mustafa11313/intelligent-cnc-vertical-drilling-machine/cad/electrical_box.png

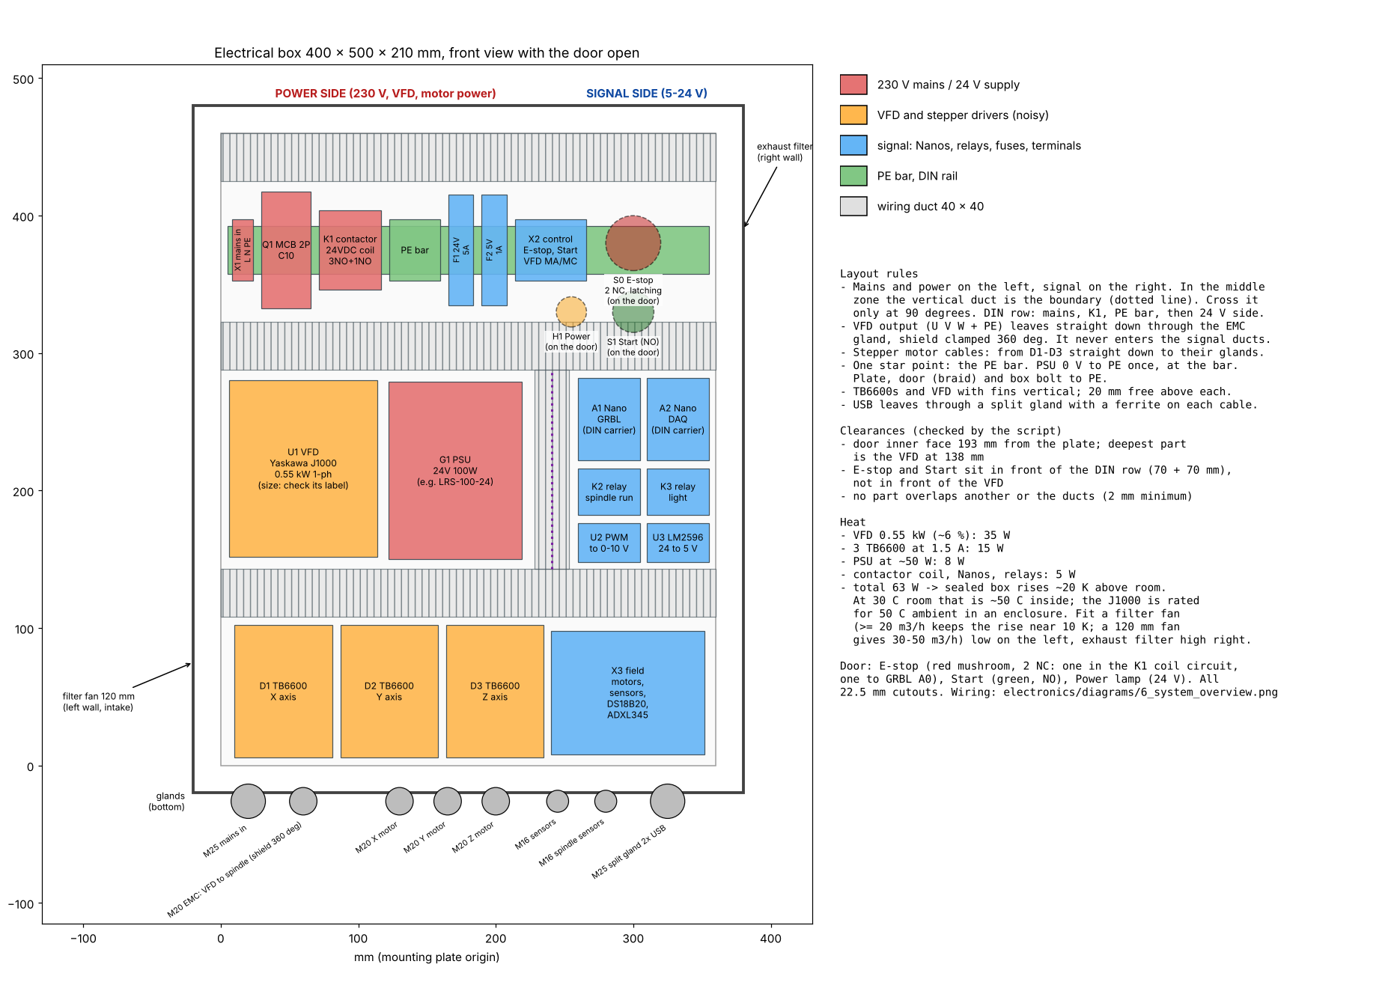
cad/electrical_box.png
