mustafa11313/intelligent-cnc-vertical-drilling-machine/cad/pictures/electrical_box_inside_closeup.png

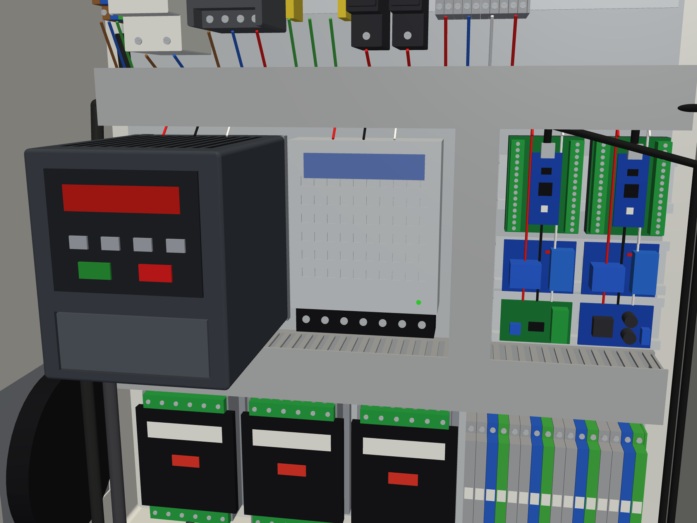
cad/pictures/electrical_box_inside_closeup.png
