mustafa11313/intelligent-cnc-vertical-drilling-machine/cad/pictures/electrical_box_iso_left.png

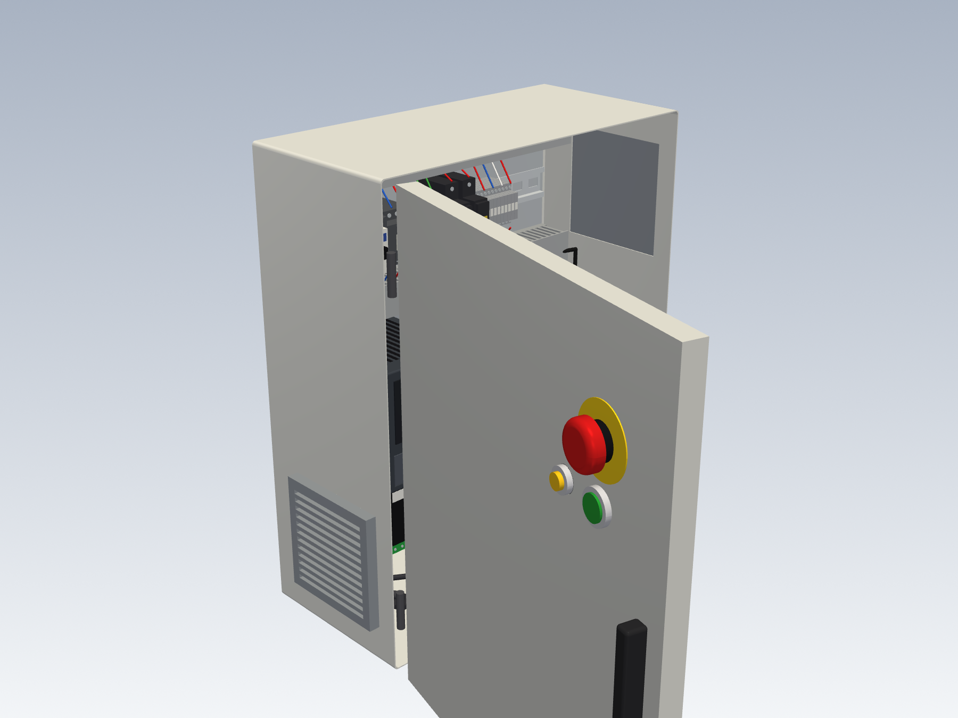
cad/pictures/electrical_box_iso_left.png
