mustafa11313/intelligent-cnc-vertical-drilling-machine/cad/pictures/machine_original_back.png

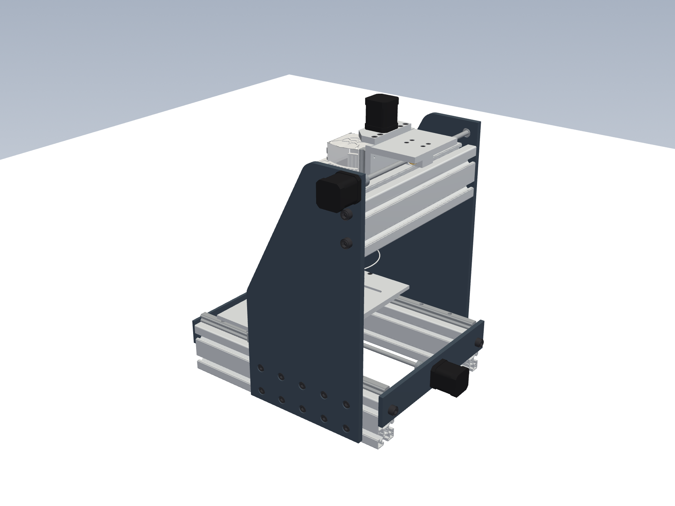
cad/pictures/machine_original_back.png
