mustafa11313/intelligent-cnc-vertical-drilling-machine/cad/pictures/machine_original_front.png

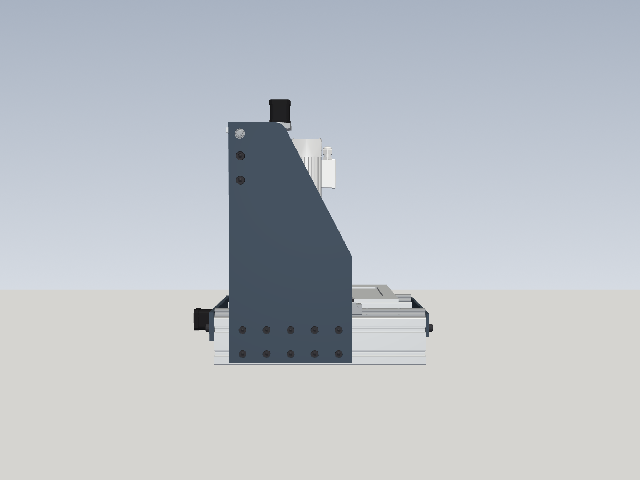
cad/pictures/machine_original_front.png
