mustafa11313/intelligent-cnc-vertical-drilling-machine/cad/pictures/machine_original_iso_front_left.png

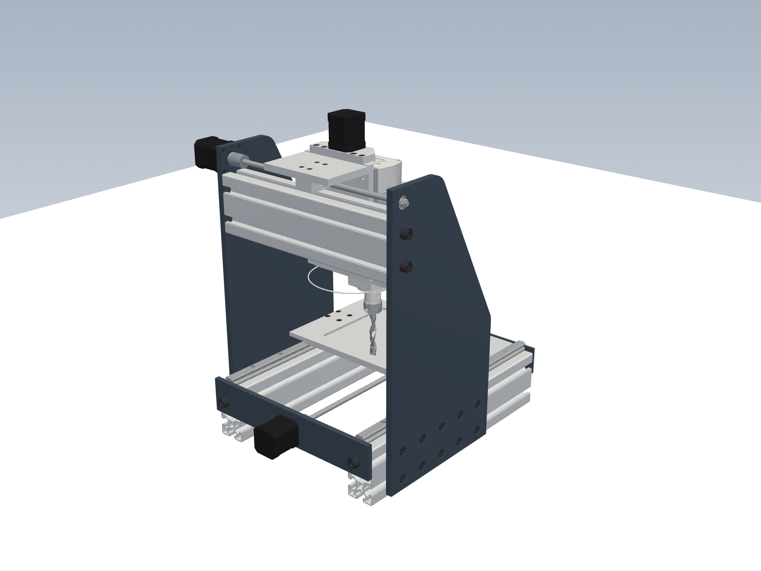
cad/pictures/machine_original_iso_front_left.png
