mustafa11313/intelligent-cnc-vertical-drilling-machine/cad/pictures/machine_original_side.png

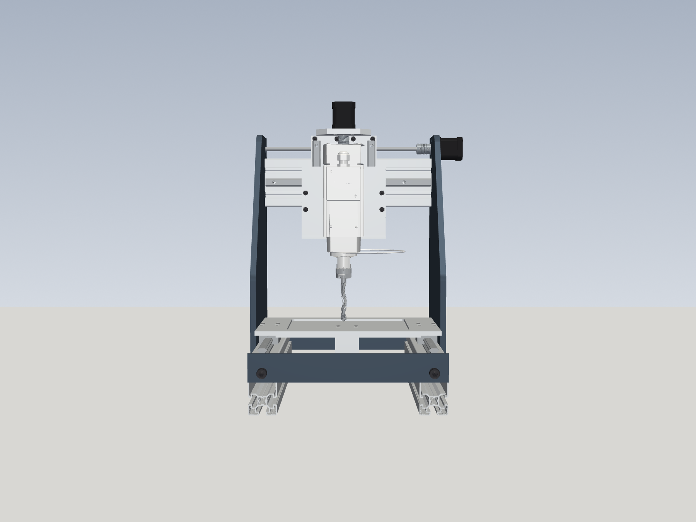
cad/pictures/machine_original_side.png
