mustafa11313/intelligent-cnc-vertical-drilling-machine/cad/pictures/machine_upgraded_head_closeup.png

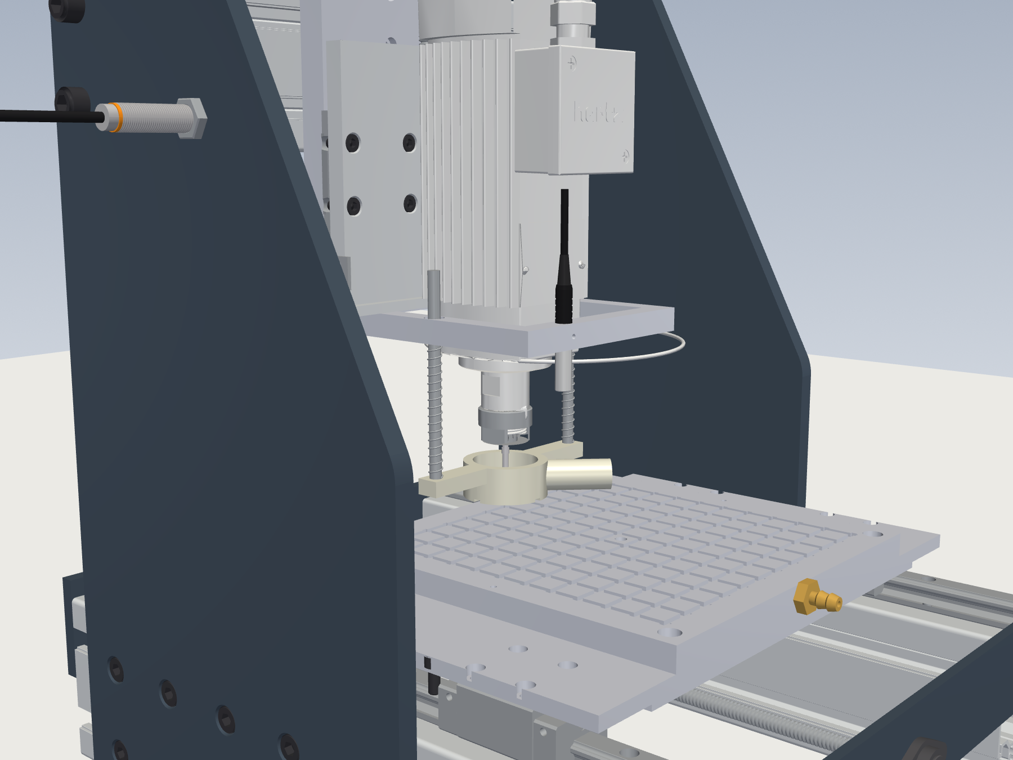
cad/pictures/machine_upgraded_head_closeup.png
