mustafa11313/intelligent-cnc-vertical-drilling-machine/cad/router/pictures/01_front_left.png

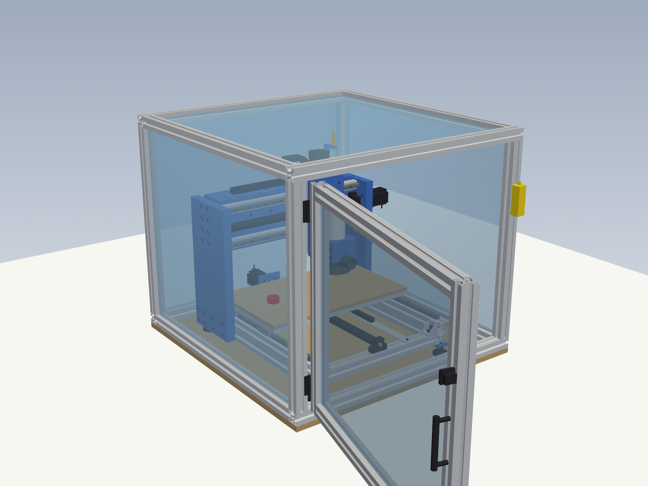
cad/router/pictures/01_front_left.png
