mustafa11313/intelligent-cnc-vertical-drilling-machine/cad/router/pictures/02_front_right.png

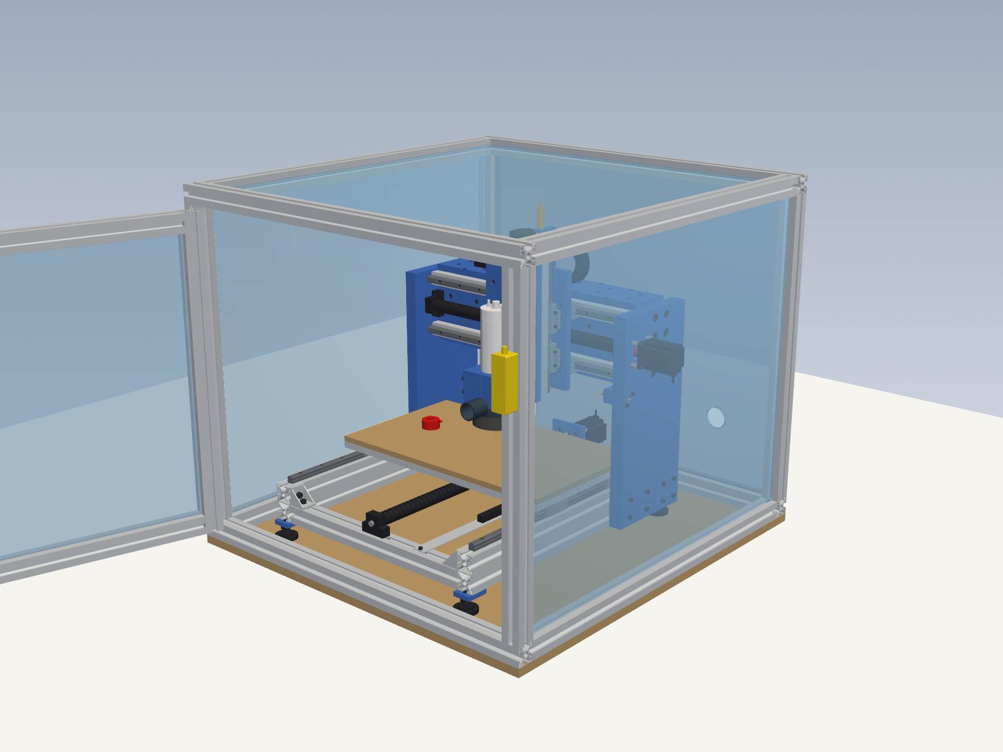
cad/router/pictures/02_front_right.png
