mustafa11313/intelligent-cnc-vertical-drilling-machine/cad/router/pictures/03_front.png

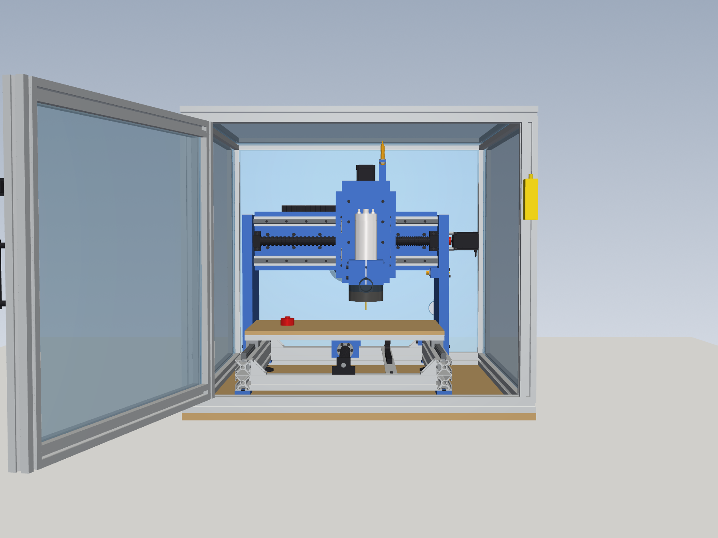
cad/router/pictures/03_front.png
