mustafa11313/intelligent-cnc-vertical-drilling-machine/cad/router/pictures/04_inside_closeup.png

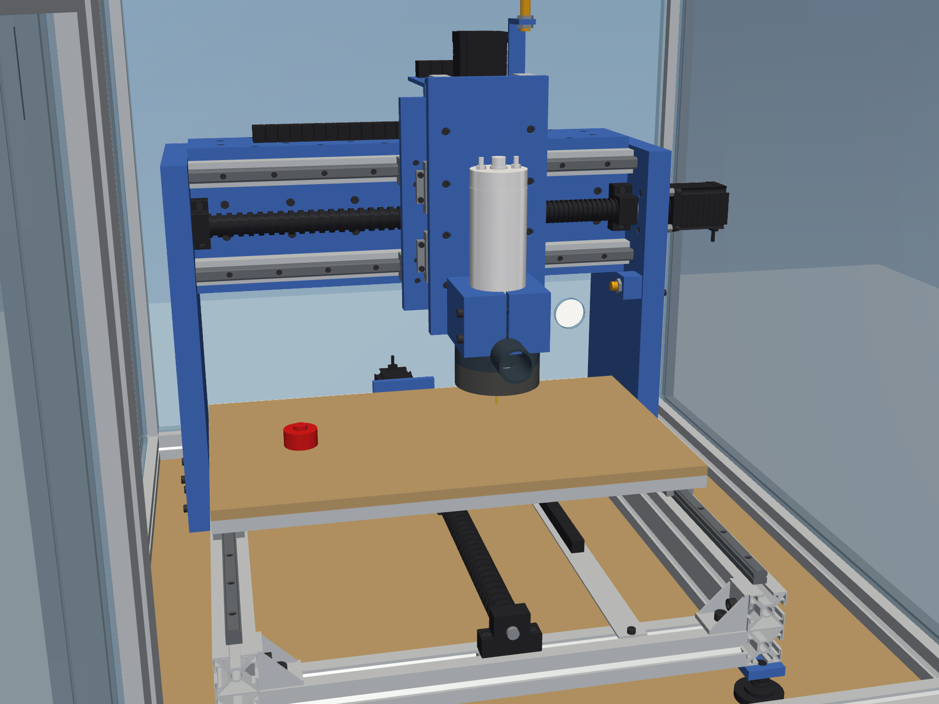
cad/router/pictures/04_inside_closeup.png
