mustafa11313/intelligent-cnc-vertical-drilling-machine/cad/router/pictures/05_top.png

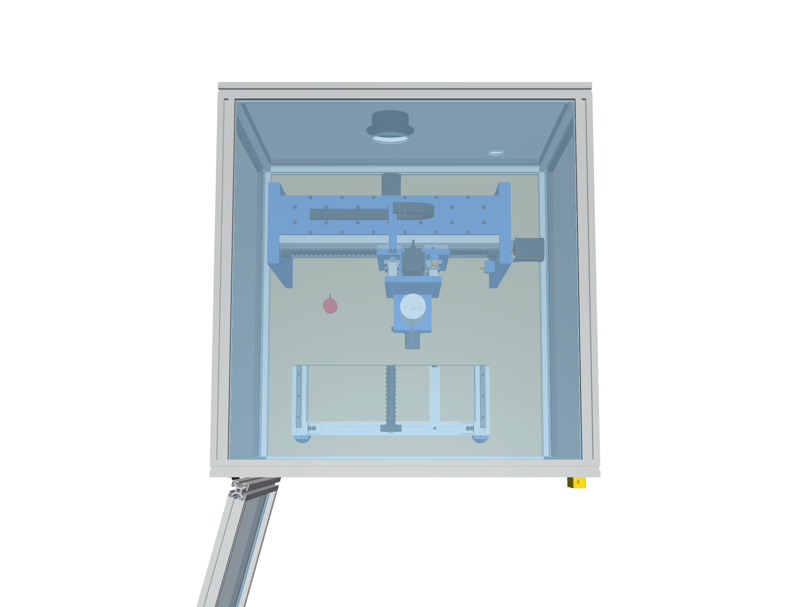
cad/router/pictures/05_top.png
