mustafa11313/intelligent-cnc-vertical-drilling-machine/cad/router/pictures/06_back_right.png

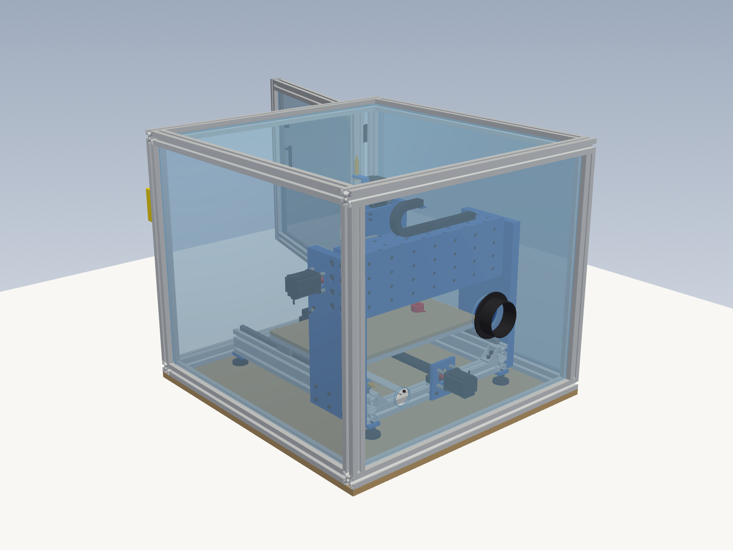
cad/router/pictures/06_back_right.png
