mustafa11313/intelligent-cnc-vertical-drilling-machine/cad/router/pictures/07_left_side.png

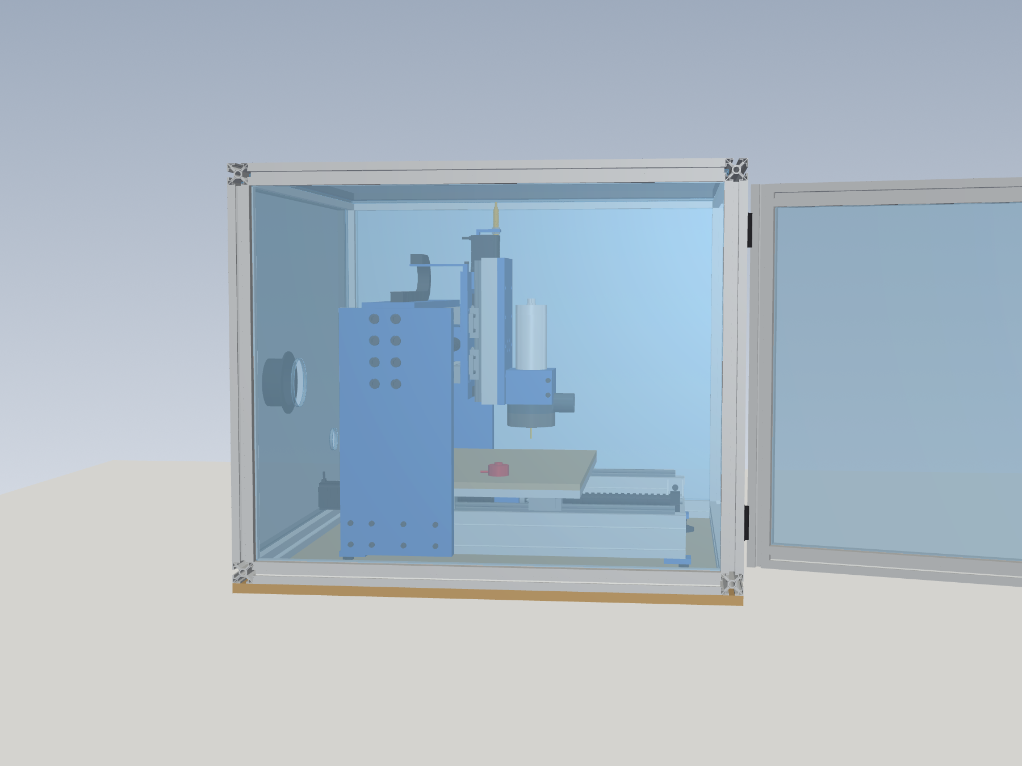
cad/router/pictures/07_left_side.png
