mustafa11313/intelligent-cnc-vertical-drilling-machine/cad/upgrade_views.png

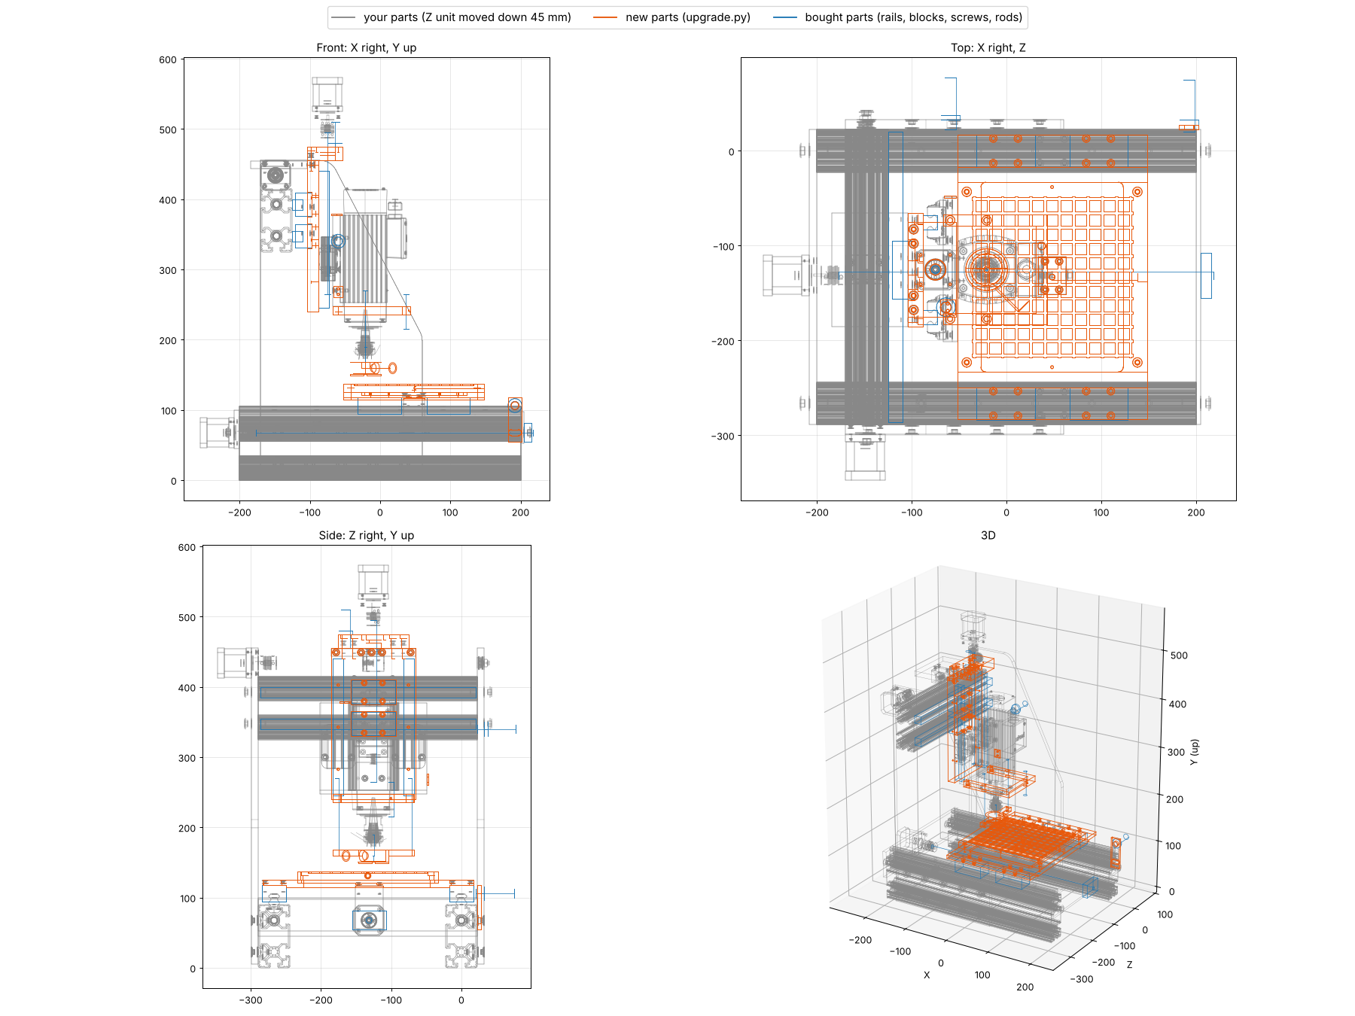
cad/upgrade_views.png
