mustafa11313/intelligent-cnc-vertical-drilling-machine/electronics/diagrams/1_mains_estop.png

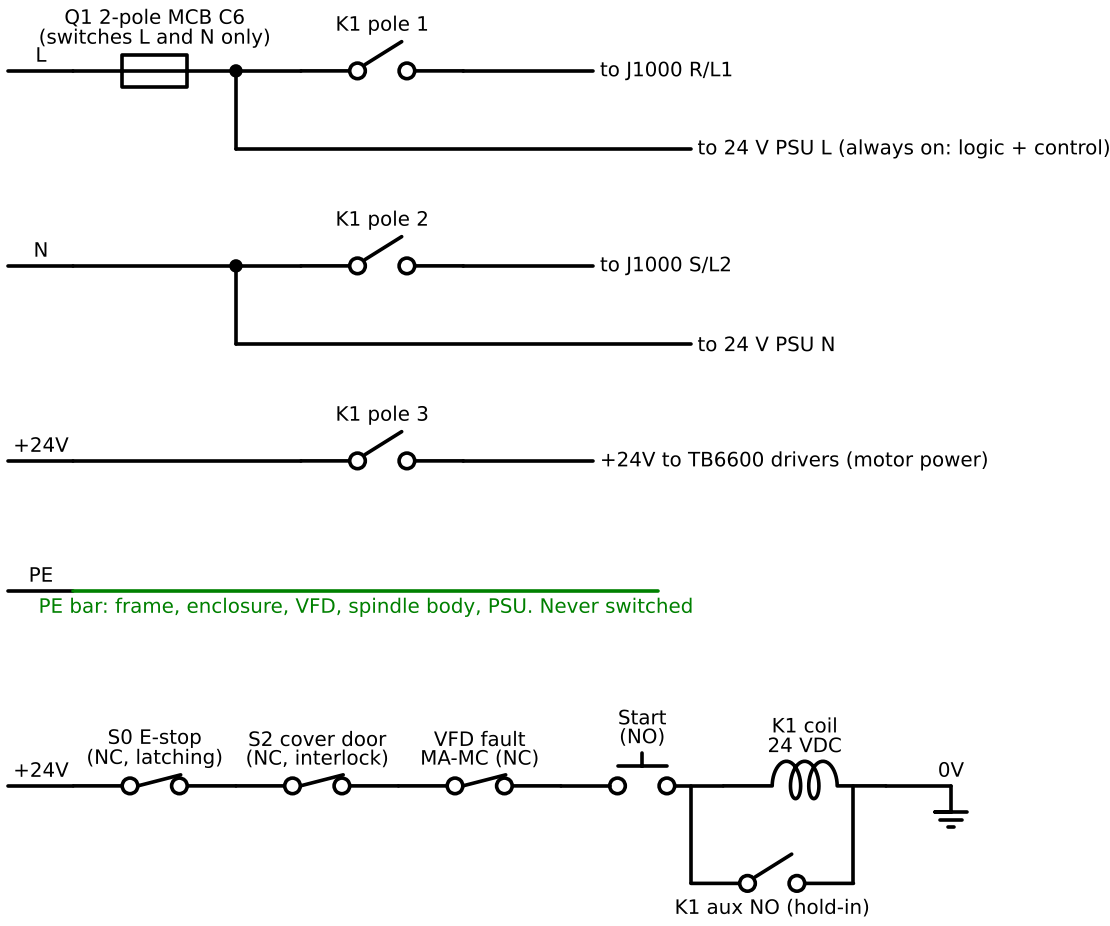
electronics/diagrams/1_mains_estop.png
