mustafa11313/intelligent-cnc-vertical-drilling-machine/electronics/diagrams/2_current_sensor.png

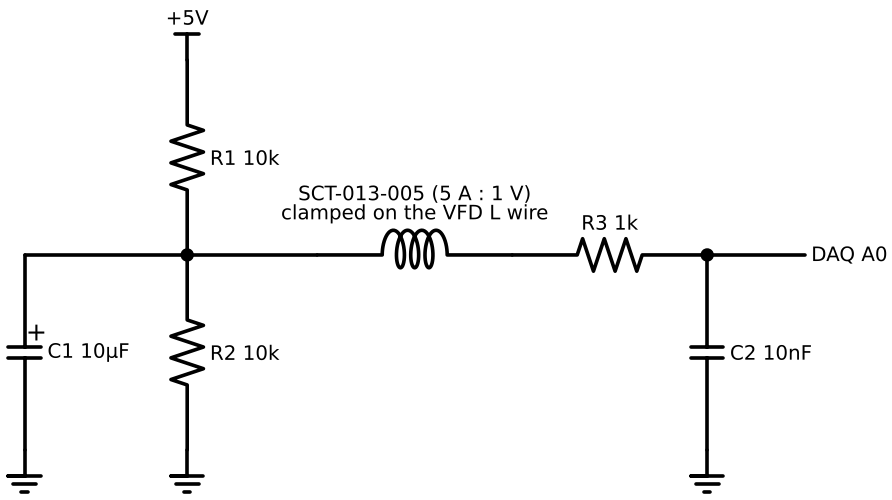
electronics/diagrams/2_current_sensor.png
