mustafa11313/intelligent-cnc-vertical-drilling-machine/electronics/diagrams/3_vfd_analog_monitor.png

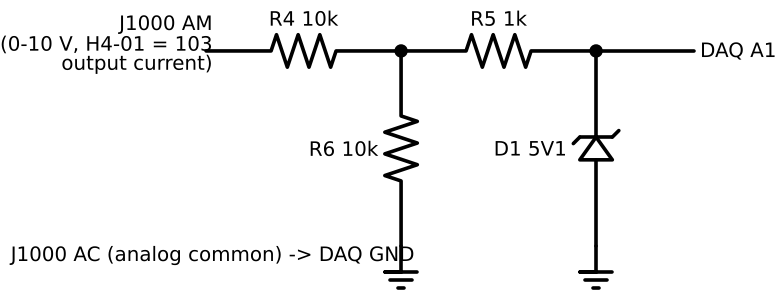
electronics/diagrams/3_vfd_analog_monitor.png
