mustafa11313/intelligent-cnc-vertical-drilling-machine/electronics/diagrams/4_limit_switch.png

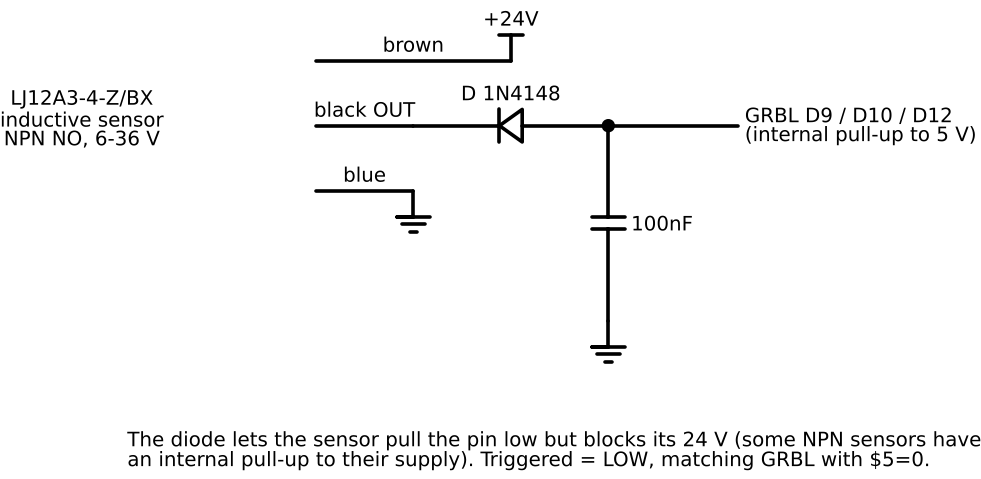
electronics/diagrams/4_limit_switch.png
