mustafa11313/intelligent-cnc-vertical-drilling-machine/electronics/diagrams/5_spindle_control.png

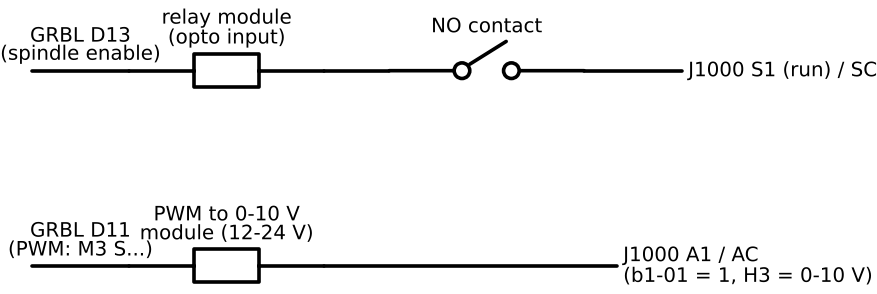
electronics/diagrams/5_spindle_control.png
