mustafa11313/intelligent-cnc-vertical-drilling-machine/electronics/diagrams/6_system_overview.png

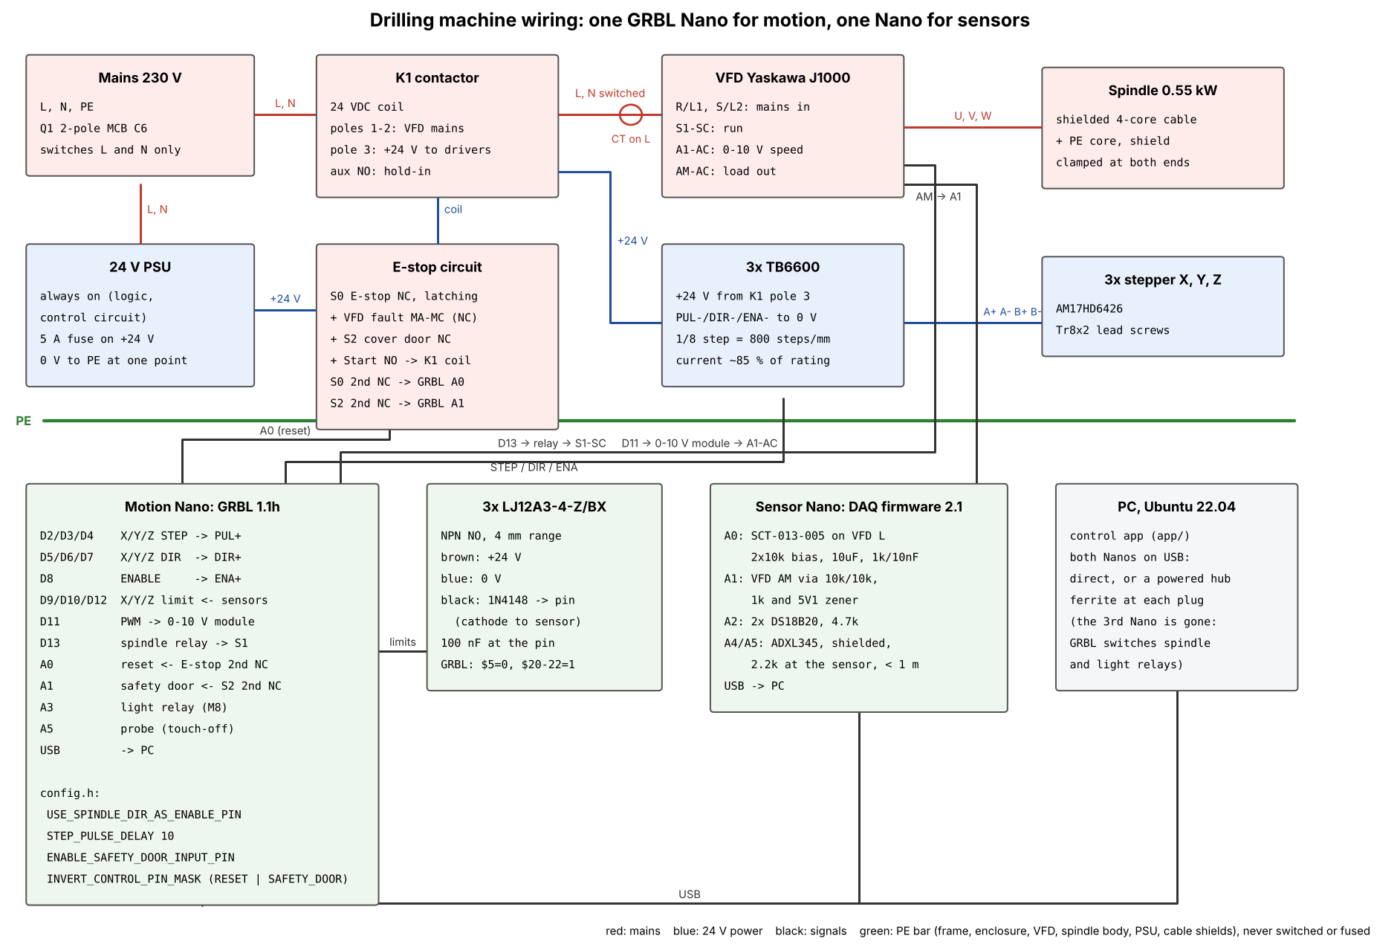
electronics/diagrams/6_system_overview.png
