mustafa11313/intelligent-cnc-vertical-drilling-machine/cad/parts_preview.png

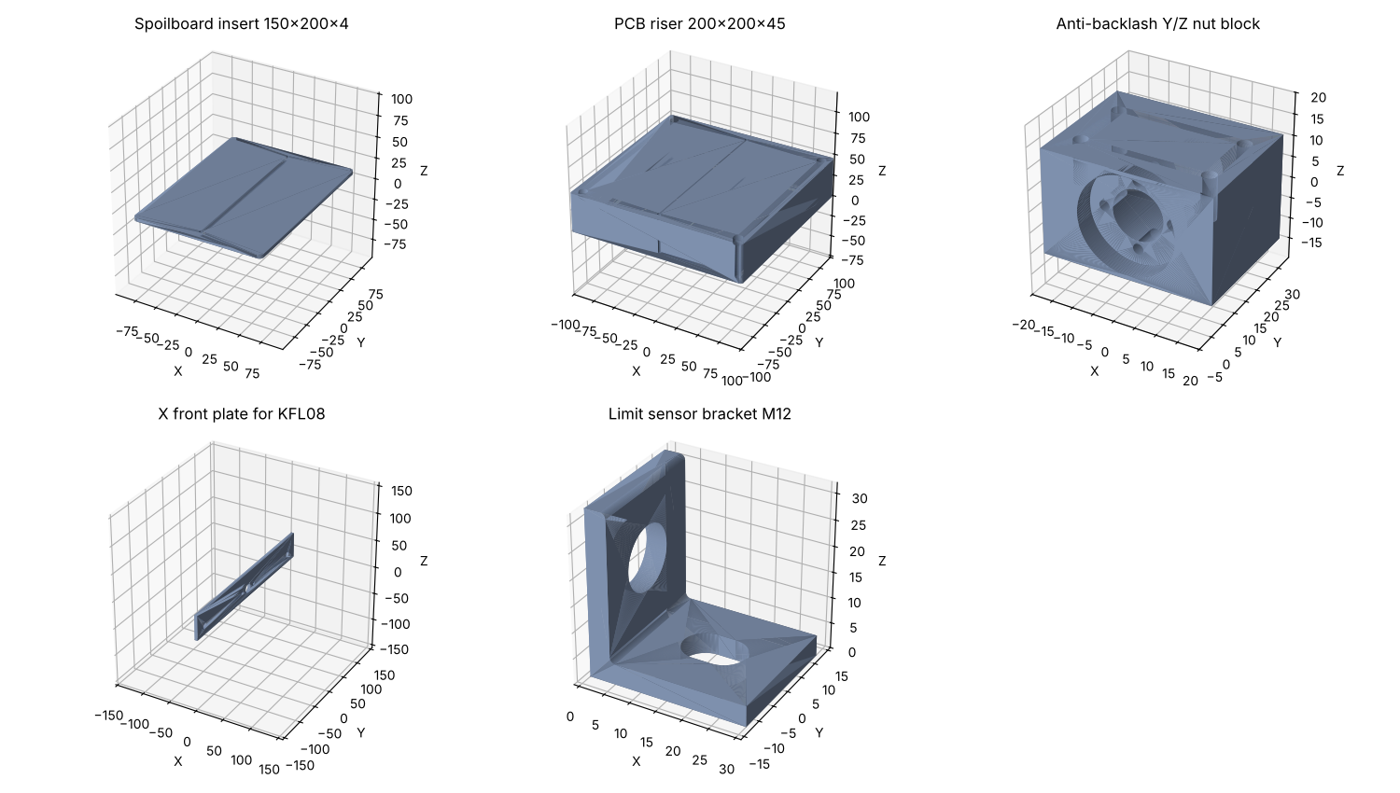
cad/parts_preview.png
