mustafa11313/intelligent-cnc-vertical-drilling-machine/cad/upgrade_parts_preview.png

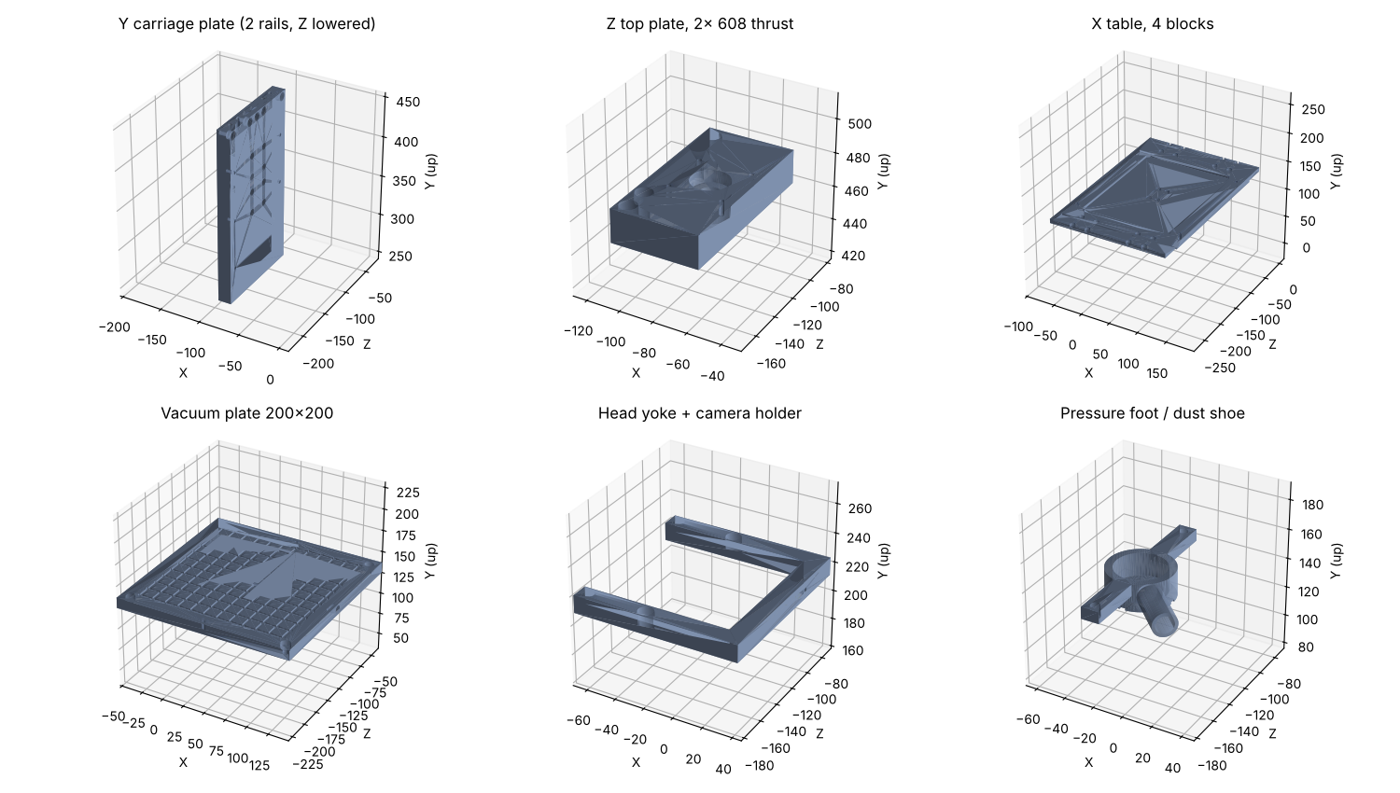
cad/upgrade_parts_preview.png
