mustafa11313/intelligent-cnc-vertical-drilling-machine/cad/step/upgrade_assembly.step

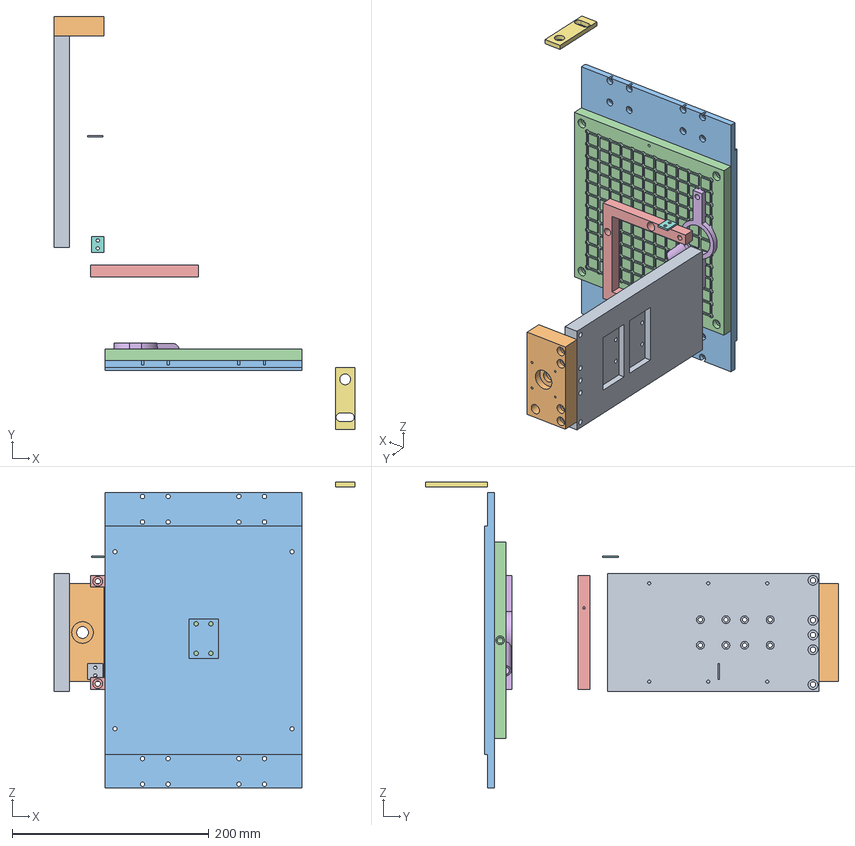
[picture p38: CAD file, 2026-11-08]
cad/step/upgrade_assembly.step
306.0 x 420.0 x 310.7 mm
y_carriage_plate
z_top_plate_608x2
x_table_4block
vacuum_plate_200x200
head_yoke_camera
pressure_foot_dustshoe
x_limit_bracket
y_home_flag
z_home_flag
