mustafa11313/intelligent-cnc-vertical-drilling-machine/cad/step/full_machine_original.step

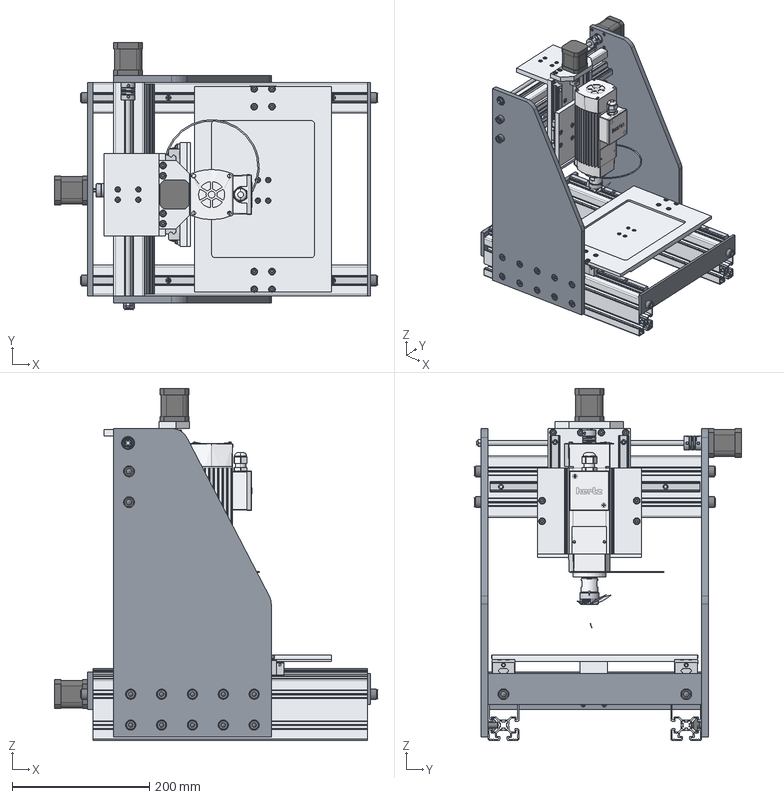
[picture p39: CAD file, 2026-11-08]
cad/step/full_machine_original.step
471.3 x 389.8 x 513.3 mm
ISO 4762 M10 x 20 - 20N
ISO 4762 M10 x 20 - 20N_2
ISO 4762 M10 x 20 - 20N_3
ISO 4762 M10 x 20 - 20N_4
On_Kapak-Son
nut_din934_m6-6
M6_DIN125 PUL
M4x12(ISO 4762 M4 x 12 - 12N)
M4x12(ISO 4762 M4 x 12 - 12N)_2
M4x12(ISO 4762 M4 x 12 - 12N)_3
M4x12(ISO 4762 M4 x 12 - 12N)_4
VidalÄ± mil somunu
X Eksen Somunu
M5x12(ISO 4762 M5 x 12 - 12N)
M5x12(ISO 4762 M5 x 12 - 12N)_2
M5x12(ISO 4762 M5 x 12 - 12N)_3
M5x12(ISO 4762 M5 x 12 - 12N)_4
M5x12(ISO 4762 M5 x 12 - 12N)_5
M5x12(ISO 4762 M5 x 12 - 12N)_6
M5x12(ISO 4762 M5 x 12 - 12N)_7
M5x12(ISO 4762 M5 x 12 - 12N)_8
300x250 Is Tablasi
hgh15ca_01
X_Trapez_Kozmetik_Tr8x2(255)
2.1.001.10.08.step
hgh15ca_01_2
ISO 4762 M8 x 16 - 16N
ISO 4762 M8 x 16 - 16N_2
ISO 4762 M8 x 16 - 16N_3
ISO 4762 M8 x 16 - 16N_4
ISO 4762 M8 x 16 - 16N_5
ISO 4762 M8 x 16 - 16N_6
ISO 4762 M8 x 16 - 16N_7
ISO 4762 M8 x 16 - 16N_8
ISO 4762 M8 x 16 - 16N_9
ISO 4762 M8 x 16 - 16N_10
ISO 4762 M8 x 16 - 16N_11
ISO 4762 M8 x 16 - 16N_12
ISO 4762 M8 x 16 - 16N_13
ISO 4762 M8 x 16 - 16N_14
ISO 4762 M8 x 16 - 16N_15
ISO 4762 M8 x 16 - 16N_16
ISO 4762 M8 x 16 - 16N_17
ISO 4762 M8 x 16 - 16N_18
ISO 4762 M8 x 16 - 16N_19
ISO 4762 M8 x 16 - 16N_20
ISO 4762 M10 x 20 - 20N_5
ISO 4762 M10 x 20 - 20N_6
ISO 4762 M10 x 20 - 20N_7
ISO 4762 M10 x 20 - 20N_8
M4x12(ISO 4762 M4 x 12 - 12N)_5
M4x12(ISO 4762 M4 x 12 - 12N)_6
M4x12(ISO 4762 M4 x 12 - 12N)_7
M4x12(ISO 4762 M4 x 12 - 12N)_8
M5x12(ISO 4762 M5 x 12 - 12N)_9
M5x12(ISO 4762 M5 x 12 - 12N)_10
M5x12(ISO 4762 M5 x 12 - 12N)_11
M5x12(ISO 4762 M5 x 12 - 12N)_12
M5x12(ISO 4762 M5 x 12 - 12N)_13
VidalÄ± mil somunu_2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
