mustafa11313/intelligent-cnc-vertical-drilling-machine/cad/original_solidworks/Step_Motor_AM17HD6426-06N.SLDASM

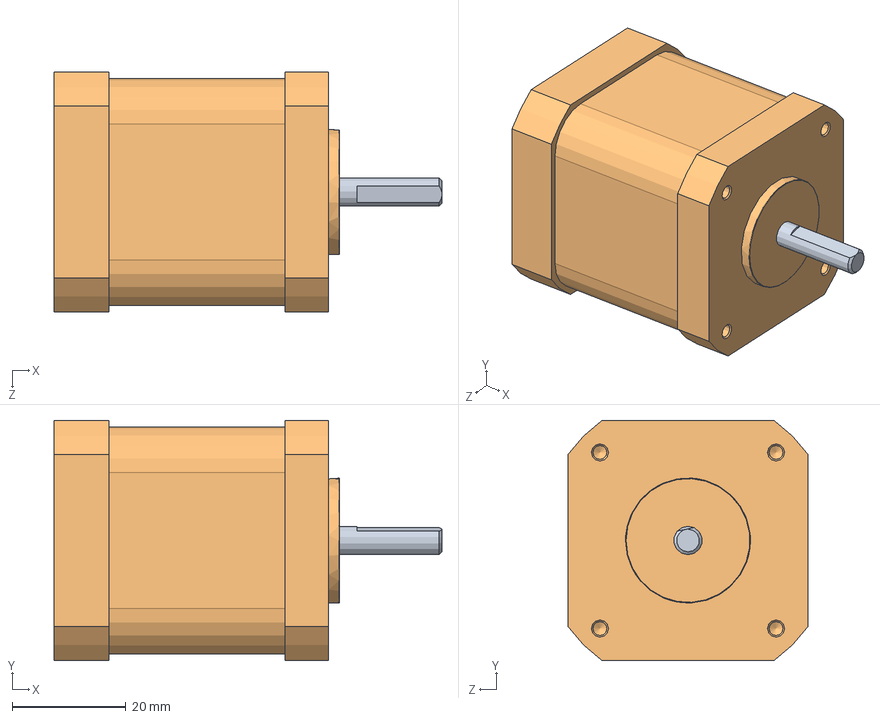
[picture p40: CAD file, 2026-11-08]
cad/original_solidworks/Step_Motor_AM17HD6426-06N.SLDASM
68.3 x 42.3 x 42.3 mm
stepper_am17hd6426-06n_01
stepper_am17hd6426-06n_02
