mustafa11313/intelligent-cnc-vertical-drilling-machine/cad/original_solidworks/ER 161.SLDPRT

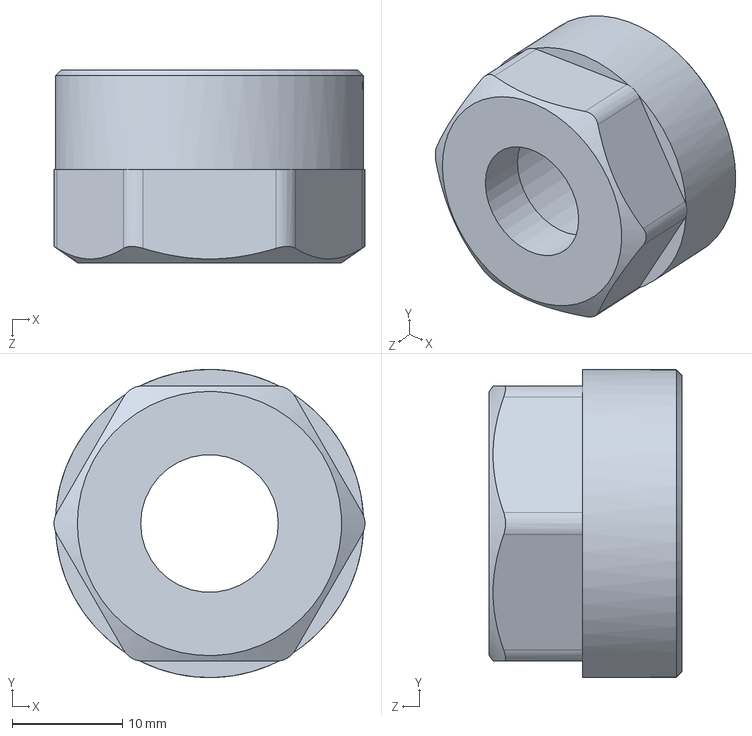
[picture p41: CAD file, 2026-11-08]
cad/original_solidworks/ER 161.SLDPRT
28.2 x 28.0 x 17.5 mm
