mustafa11313/intelligent-cnc-vertical-drilling-machine/cad/step/upgrade/pressure_foot_dustshoe.step

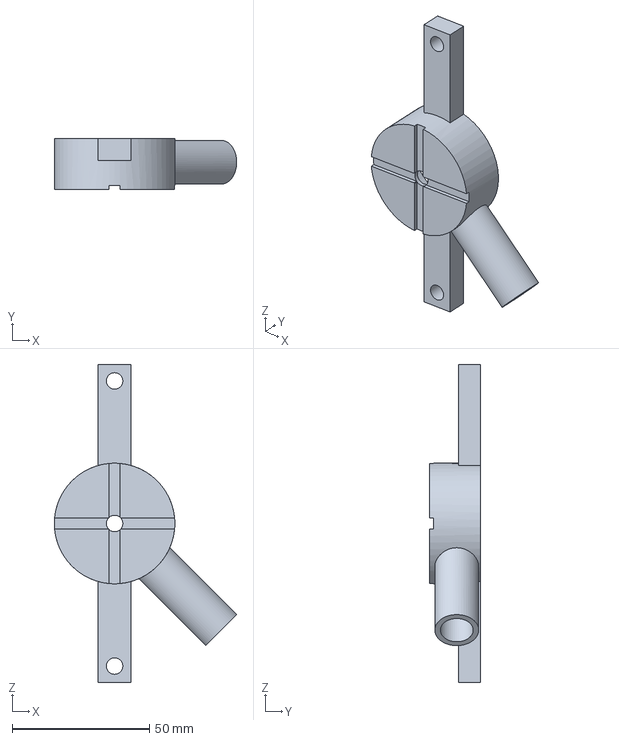
[picture p42: CAD file, 2026-11-08]
cad/step/upgrade/pressure_foot_dustshoe.step
66.5 x 18.7 x 116.0 mm
