mustafa11313/intelligent-cnc-vertical-drilling-machine/cad/original_solidworks/Yan_Plaka_2.SLDPRT

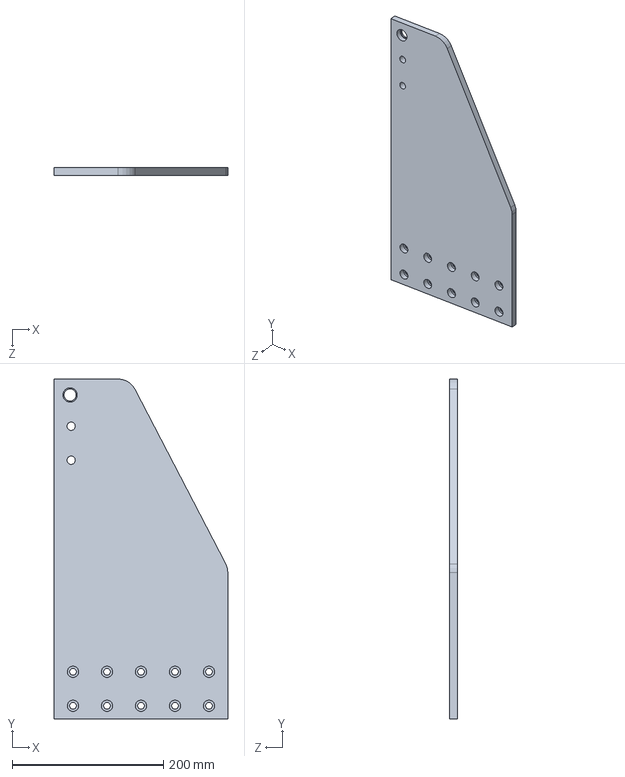
[picture p44: CAD file, 2026-11-08]
cad/original_solidworks/Yan_Plaka_2.SLDPRT
230.0 x 450.0 x 10.0 mm
