mustafa11313/intelligent-cnc-vertical-drilling-machine/cad/step/enclosure.step

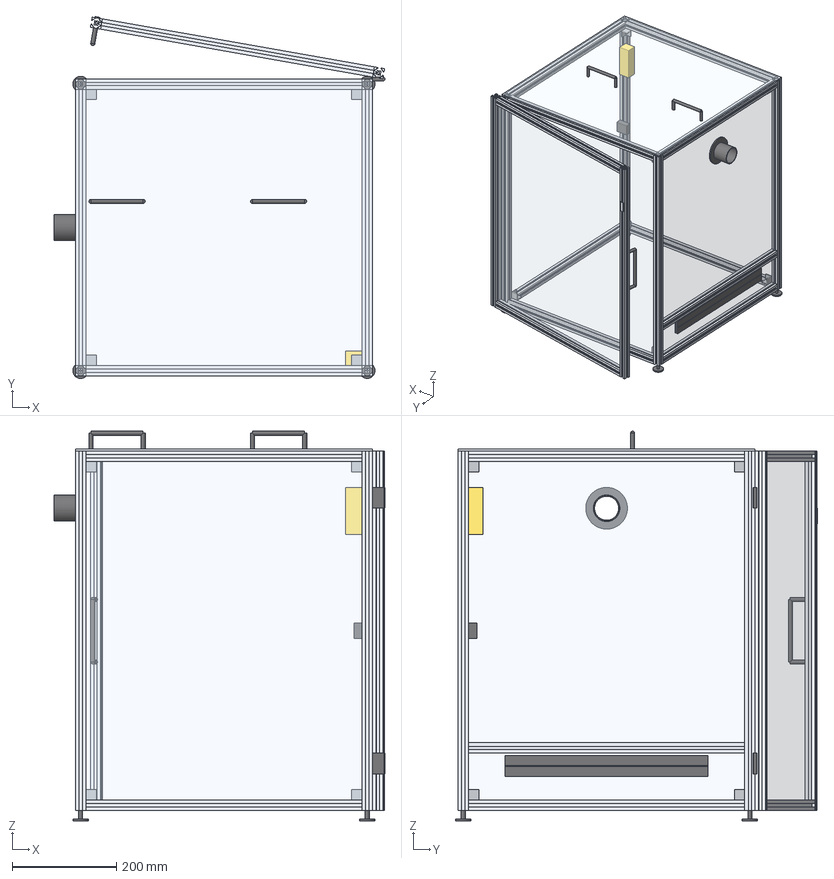
[picture p45: CAD file, 2026-11-08]
cad/step/enclosure.step
635.0 x 694.8 x 748.0 mm
profile 20x20 vertical
profile 20x20 vertical_2
profile 20x20 vertical_3
profile 20x20 vertical_4
profile 20x20 X
profile 20x20 X_2
profile 20x20 Z
profile 20x20 Z_2
profile 20x20 X_3
profile 20x20 X_4
profile 20x20 Z_3
profile 20x20 Z_4
profile 20x20 Z_5
corner bracket 20
corner bracket 20_2
corner bracket 20_3
corner bracket 20_4
corner bracket 20_5
corner bracket 20_6
corner bracket 20_7
corner bracket 20_8
polycarbonate side panel
polycarbonate side panel_2
polycarbonate back panel, low (cable entry)
brush strip cable entry
polycarbonate back panel, high
extraction port 50 mm
polycarbonate lid 6 mm (removable)
lid handle
lid handle_2
door profile vertical
door profile vertical_2
door profile horizontal
door profile horizontal_2
polycarbonate door panel
door handle
interlock actuator key
door hinge
door hinge_2
door interlock switch 2NC (e.g. Omron D4NS)
magnetic catch
levelling foot M8
levelling foot M8_2
levelling foot M8_3
levelling foot M8_4
