mustafa11313/intelligent-cnc-vertical-drilling-machine/cad/step/upgrade/z_top_plate_608x2.step

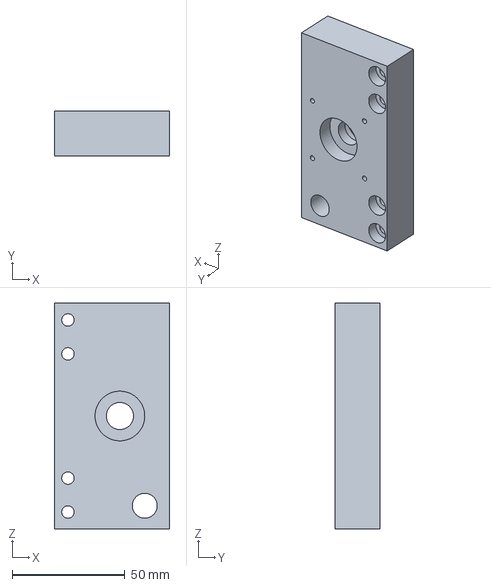
[picture p46: CAD file, 2026-11-08]
cad/step/upgrade/z_top_plate_608x2.step
51.0 x 20.0 x 100.0 mm
