mustafa11313/intelligent-cnc-vertical-drilling-machine/tests/data/Spicemen.DXF

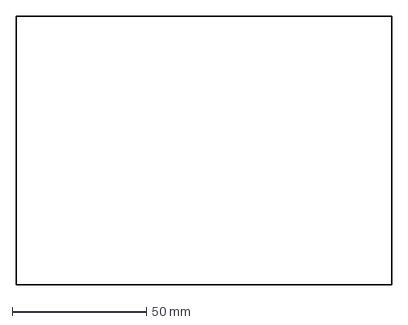
[picture p47: CAD file, 2026-11-08]
tests/data/Spicemen.DXF
140.0 x 100.0 mm
