mustafa11313/intelligent-cnc-vertical-drilling-machine/cad/original_solidworks/M3 x12.SLDPRT

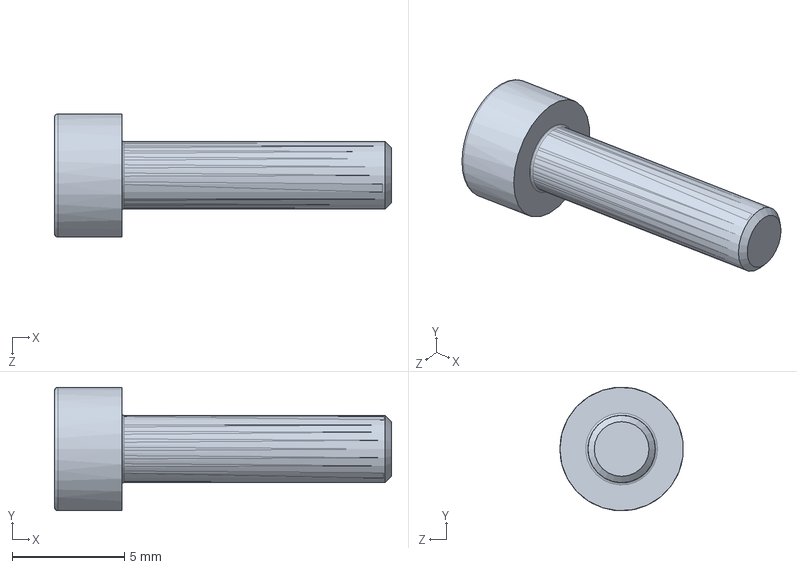
[picture p48: CAD file, 2026-11-08]
cad/original_solidworks/M3 x12.SLDPRT
15.0 x 5.49 x 5.49 mm
