mustafa11313/intelligent-cnc-vertical-drilling-machine/cad/step/electrical_box.step

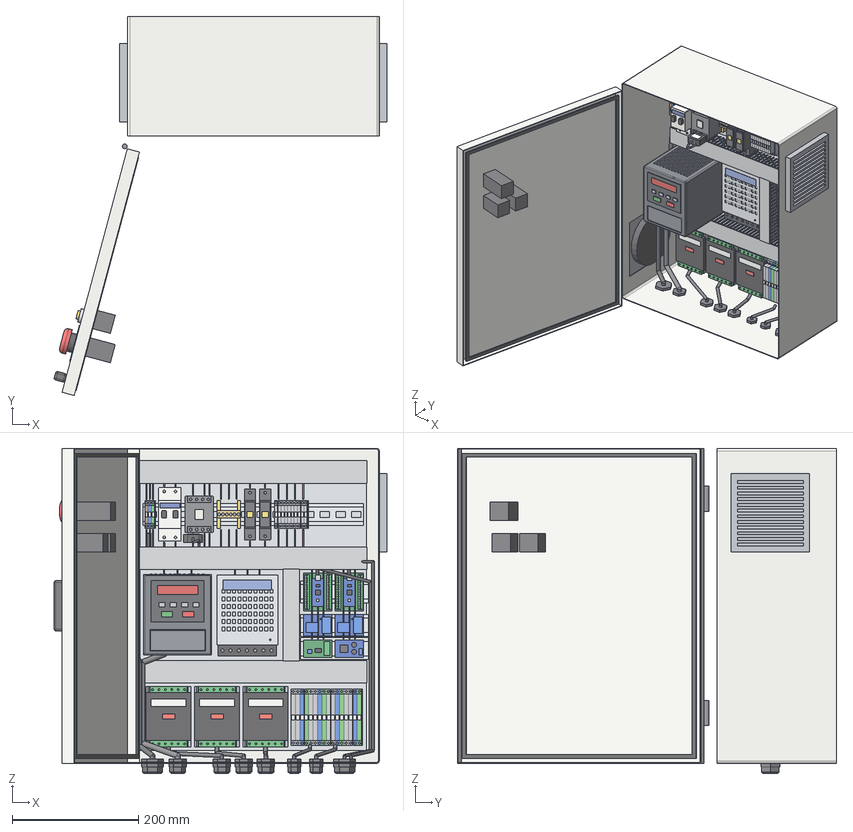
[picture p49: CAD file, 2026-11-08]
cad/step/electrical_box.step
528.1 x 601.5 x 516.5 mm
enclosure 400x500x210 RAL7035
mounting plate galvanised
plate standoff
plate standoff_2
plate standoff_3
plate standoff_4
wiring duct
duct cover
wiring duct_2
duct cover_2
wiring duct_3
duct cover_3
wiring duct_4
duct cover_4
DIN rail TS35
DIN rail TS35_2
DIN rail TS35_3
DIN rail TS35_4
X1_mains terminal
X1_mains screw
X1_mains screw_2
X1_mains marker
X1_mains terminal_2
X1_mains screw_3
X1_mains screw_4
X1_mains marker_2
X1_mains terminal_3
X1_mains screw_5
X1_mains screw_6
X1_mains marker_3
X1_mains end plate
Q1_mcb MCB body
Q1_mcb MCB toggle
Q1_mcb MCB screw
Q1_mcb MCB screw_2
Q1_mcb MCB toggle_2
Q1_mcb MCB screw_3
Q1_mcb MCB screw_4
Q1_mcb MCB label C10
K1_contactor contactor LC1K
K1_contactor contactor window
K1_contactor screw
K1_contactor screw_2
K1_contactor screw_3
K1_contactor screw_4
K1_contactor screw_5
K1_contactor screw_6
K1_contactor screw_7
K1_contactor screw_8
PE_bar PE bar insulator
PE_bar PE bar insulator_2
PE_bar PE bar
PE_bar PE screw
PE_bar PE screw_2
PE_bar PE screw_3
PE_bar PE screw_4
PE_bar PE screw_5
PE_bar PE screw_6
F1_fuse fuse holder
F1_fuse fuse carrier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
