mustafa11313/intelligent-cnc-vertical-drilling-machine/cad/step/upgrade/y_home_flag.step

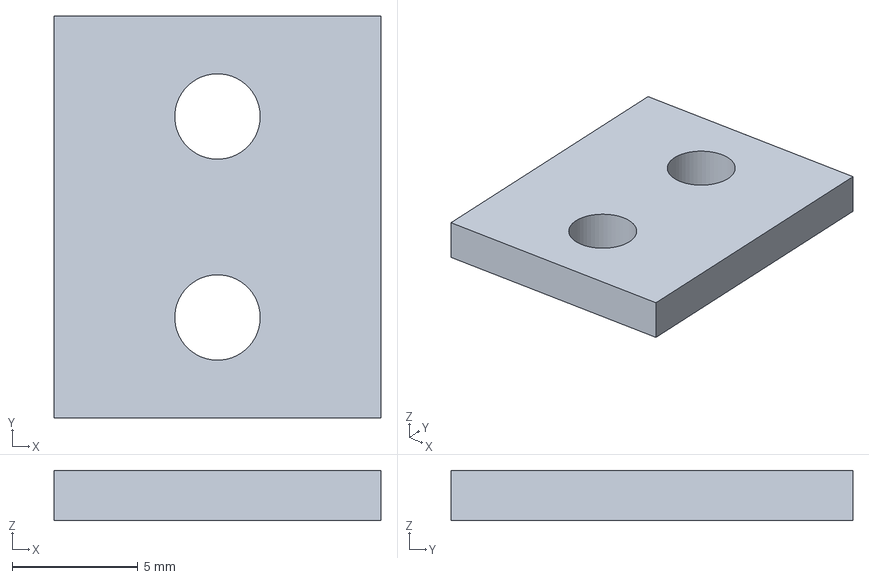
[picture p50: CAD file, 2026-11-08]
cad/step/upgrade/y_home_flag.step
13.0 x 16.0 x 2.00 mm
