mustafa11313/intelligent-cnc-vertical-drilling-machine/cad/original_solidworks/Y eksen takozu.SLDPRT

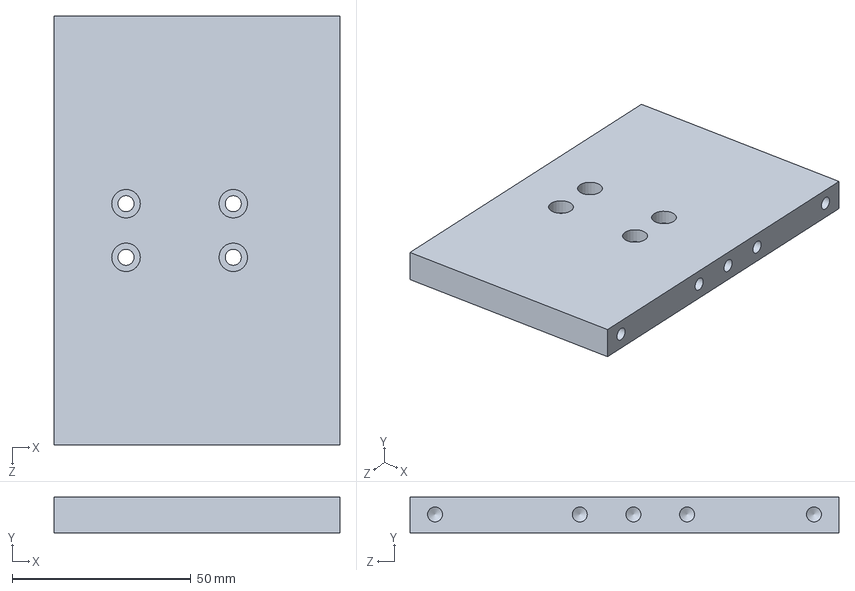
[picture p51: CAD file, 2026-11-08]
cad/original_solidworks/Y eksen takozu.SLDPRT
80.0 x 10.0 x 120.0 mm
