mustafa11313/intelligent-cnc-vertical-drilling-machine/cad/step/upgrade/z_home_flag.step

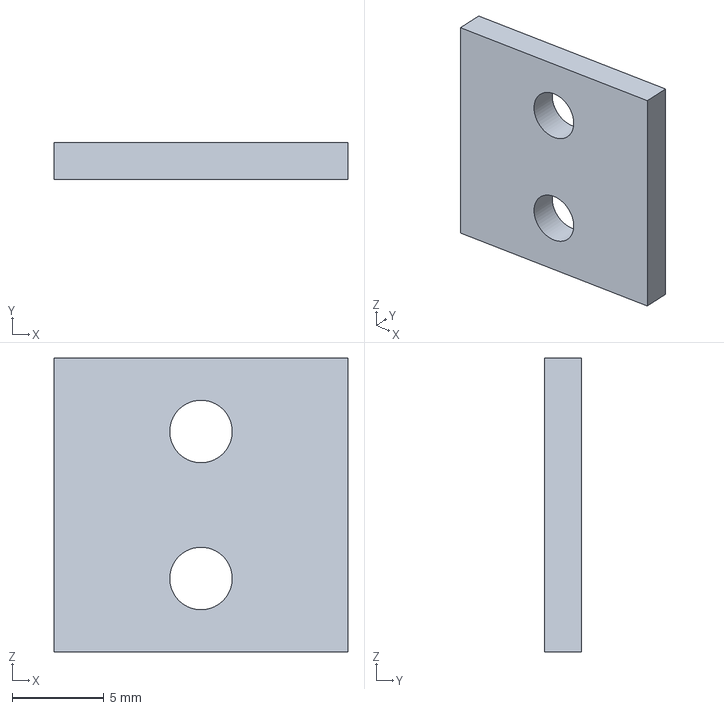
[picture p52: CAD file, 2026-11-08]
cad/step/upgrade/z_home_flag.step
16.0 x 2.00 x 16.0 mm
