mustafa11313/intelligent-cnc-vertical-drilling-machine/tests/data/test.DXF

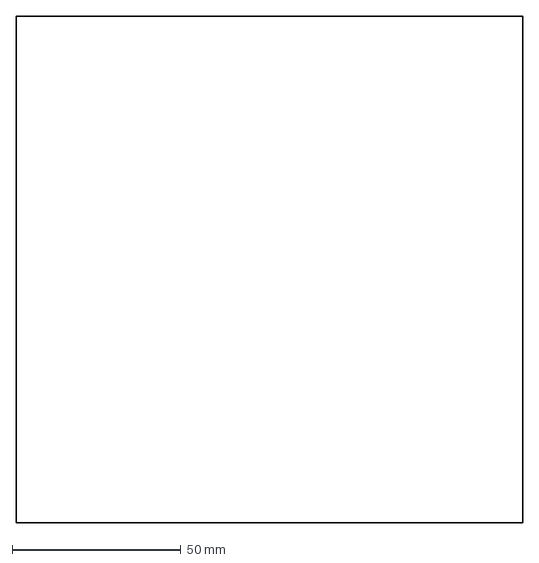
[picture p53: CAD file, 2026-11-08]
tests/data/test.DXF
150.0 x 150.0 mm
