mustafa11313/intelligent-cnc-vertical-drilling-machine/cad/original_solidworks/2.1.001.10.08.step.SLDPRT

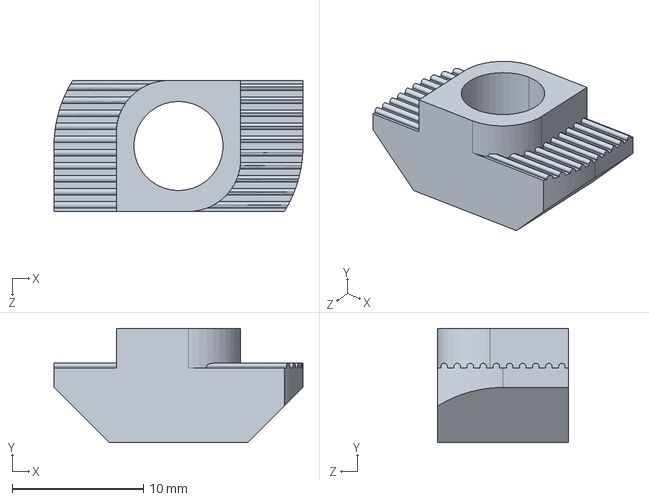
[picture p54: CAD file, 2026-11-08]
cad/original_solidworks/2.1.001.10.08.step.SLDPRT
19.0 x 8.70 x 10.0 mm
