mustafa11313/intelligent-cnc-vertical-drilling-machine/cad/step/upgrade/x_table_4block.step

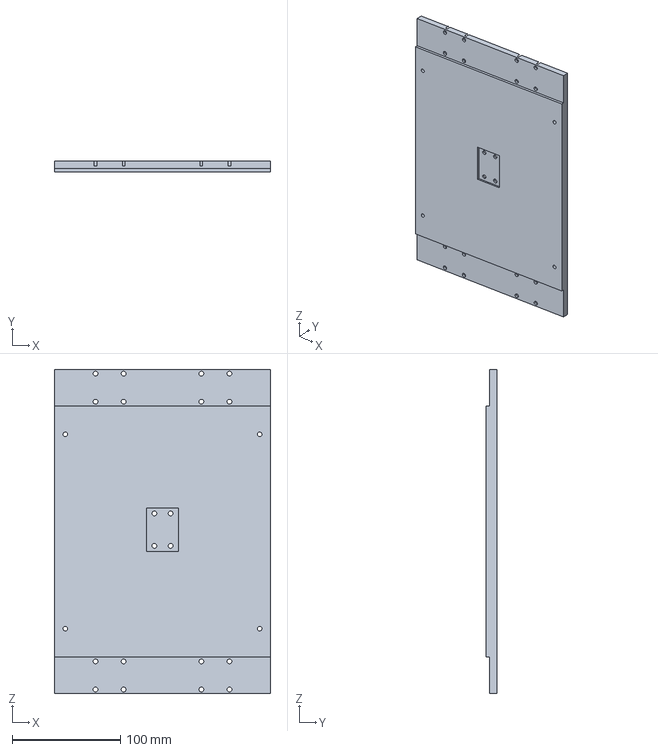
[picture p55: CAD file, 2026-11-08]
cad/step/upgrade/x_table_4block.step
200.0 x 10.0 x 300.0 mm
