mustafa11313/intelligent-cnc-vertical-drilling-machine/tests/data/Spicemen2.DXF

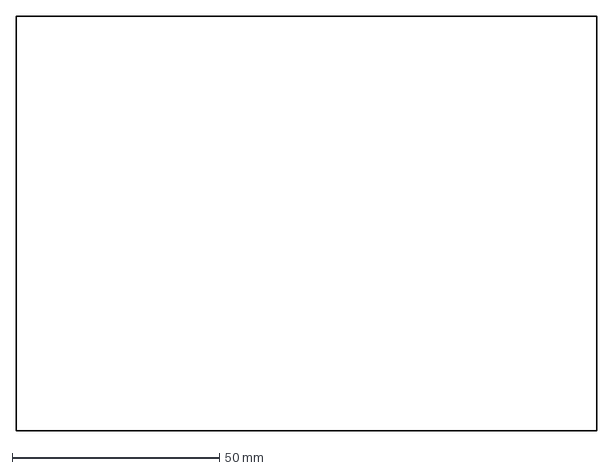
[picture p56: CAD file, 2026-11-08]
tests/data/Spicemen2.DXF
140.0 x 100.0 mm
