mustafa11313/intelligent-cnc-vertical-drilling-machine/cad/step/upgrade/head_yoke_camera.step

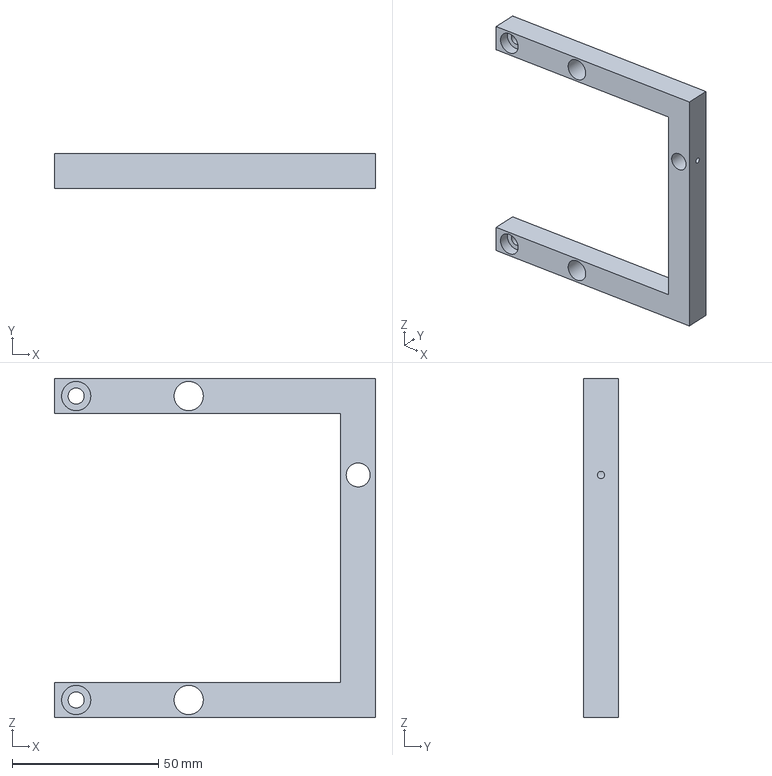
[picture p57: CAD file, 2026-11-08]
cad/step/upgrade/head_yoke_camera.step
110.0 x 12.0 x 116.0 mm
