mustafa11313/intelligent-cnc-vertical-drilling-machine/tests/data/test2.DXF

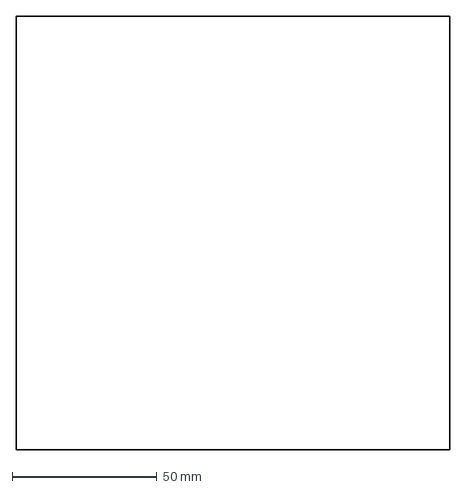
[picture p58: CAD file, 2026-11-08]
tests/data/test2.DXF
150.0 x 150.0 mm
