mustafa11313/intelligent-cnc-vertical-drilling-machine/cad/original_solidworks/Arka Kapak.SLDPRT

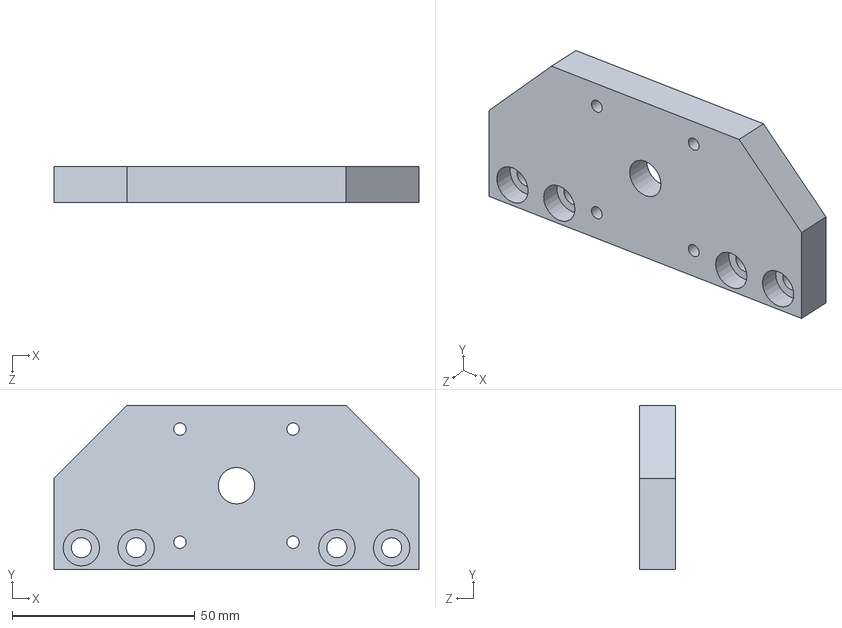
[picture p59: CAD file, 2026-11-08]
cad/original_solidworks/Arka Kapak.SLDPRT
100.0 x 45.0 x 10.0 mm
