mustafa11313/intelligent-cnc-vertical-drilling-machine/cad/step/upgrade/vacuum_plate_200x200.step

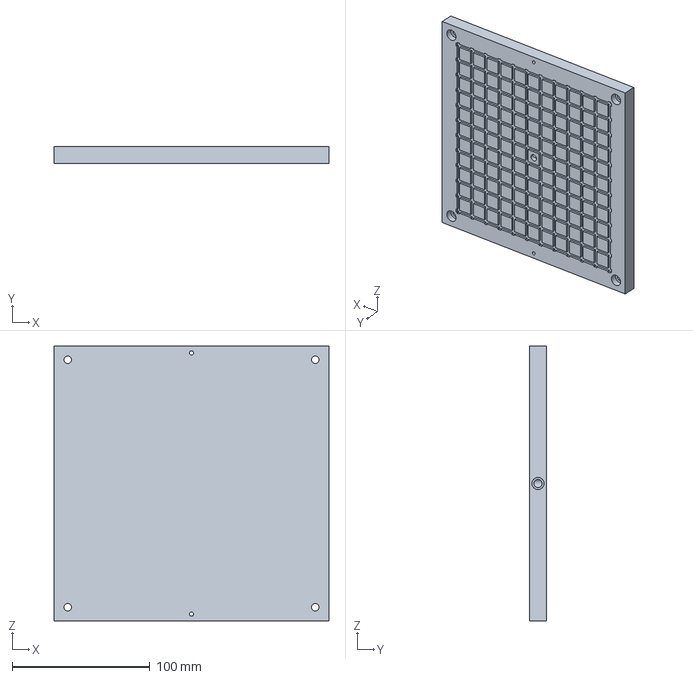
[picture p60: CAD file, 2026-11-08]
cad/step/upgrade/vacuum_plate_200x200.step
200.0 x 12.0 x 200.0 mm
