mustafa11313/intelligent-cnc-vertical-drilling-machine/cad/original_solidworks/626.SLDPRT

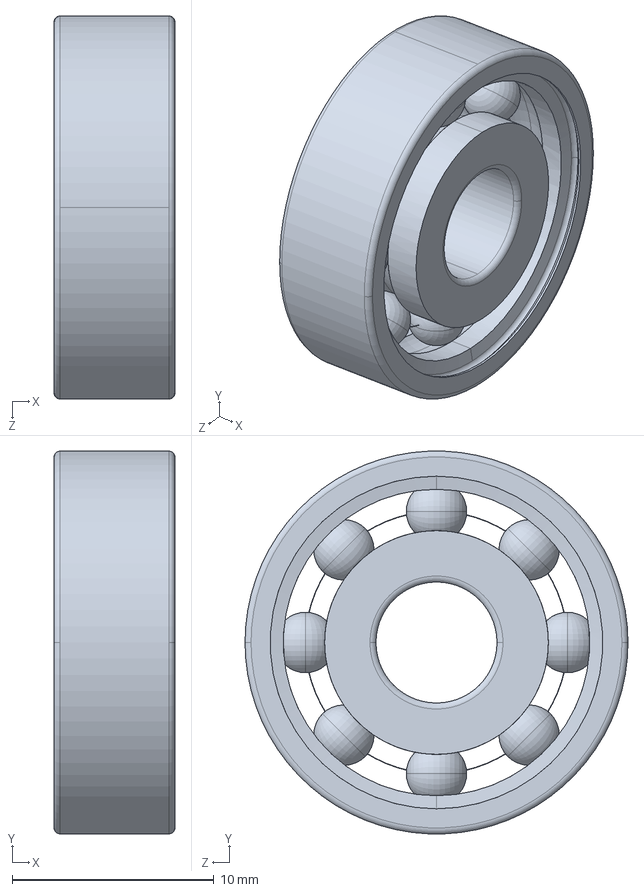
[picture p61: CAD file, 2026-11-08]
cad/original_solidworks/626.SLDPRT
6.00 x 19.0 x 19.0 mm
