mustafa11313/intelligent-cnc-vertical-drilling-machine/cad/step/spoilboard_insert_150x200.step

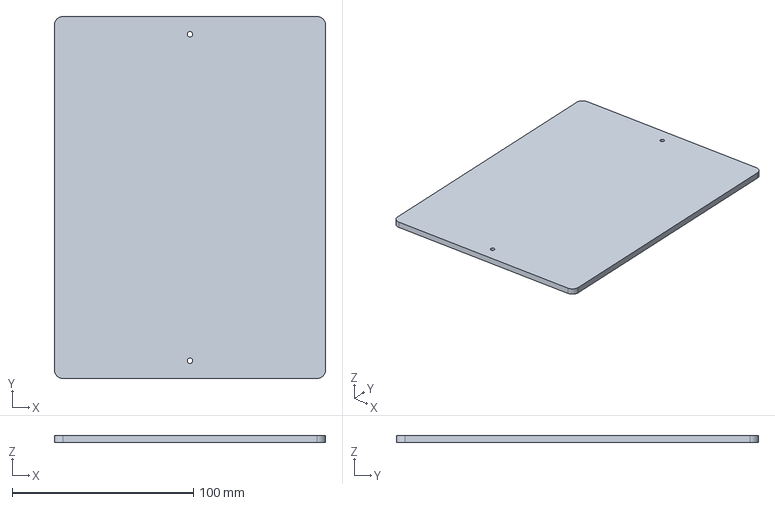
[picture p62: CAD file, 2026-11-08]
cad/step/spoilboard_insert_150x200.step
149.6 x 199.6 x 4.00 mm
