mustafa11313/intelligent-cnc-vertical-drilling-machine/cad/step/upgrade/y_carriage_plate.step

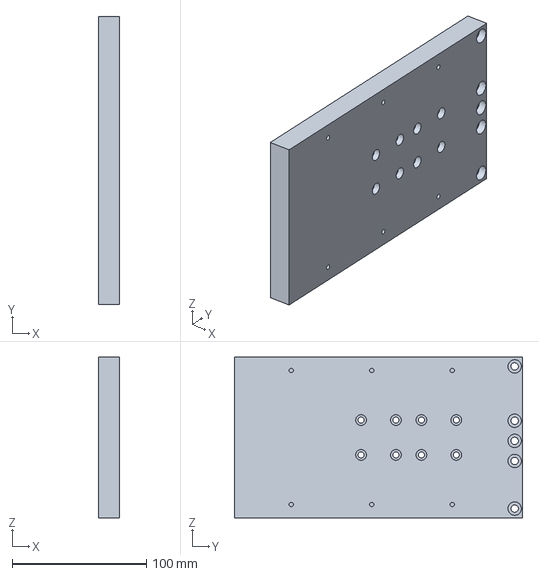
[picture p63: CAD file, 2026-11-08]
cad/step/upgrade/y_carriage_plate.step
16.0 x 215.0 x 120.0 mm
