mustafa11313/intelligent-cnc-vertical-drilling-machine/cad/step/upgrade/x_limit_bracket.step

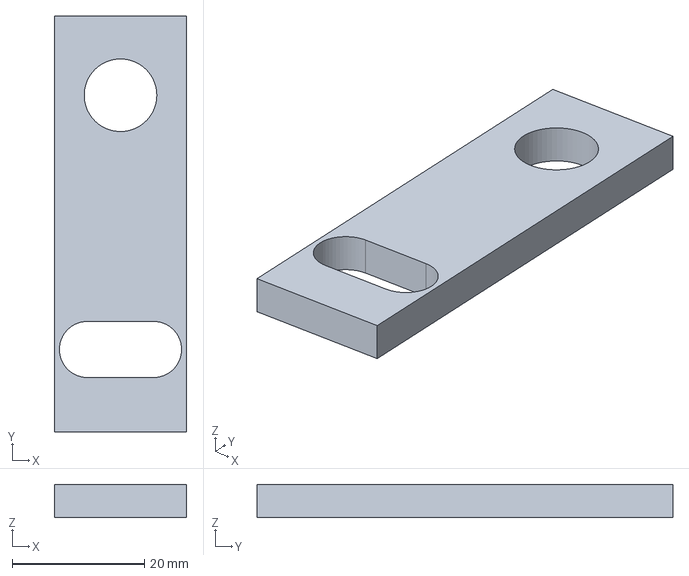
[picture p64: CAD file, 2026-11-08]
cad/step/upgrade/x_limit_bracket.step
20.0 x 63.0 x 5.00 mm
