mustafa11313/intelligent-cnc-vertical-drilling-machine/cad/step/x_front_plate_KFL08.step

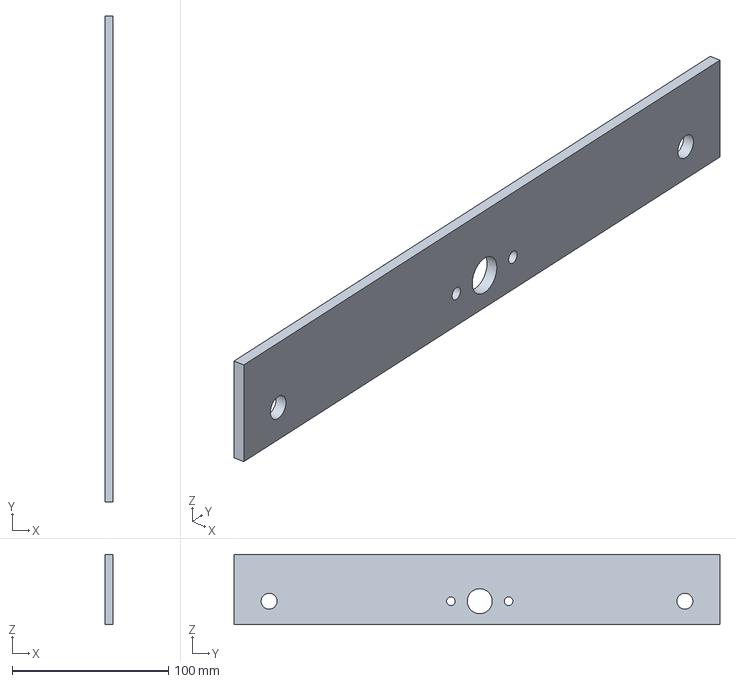
[picture p65: CAD file, 2026-11-08]
cad/step/x_front_plate_KFL08.step
5.00 x 311.5 x 45.0 mm
