mustafa11313/intelligent-cnc-vertical-drilling-machine/cad/original_solidworks/M6_DIN125 PUL.SLDPRT

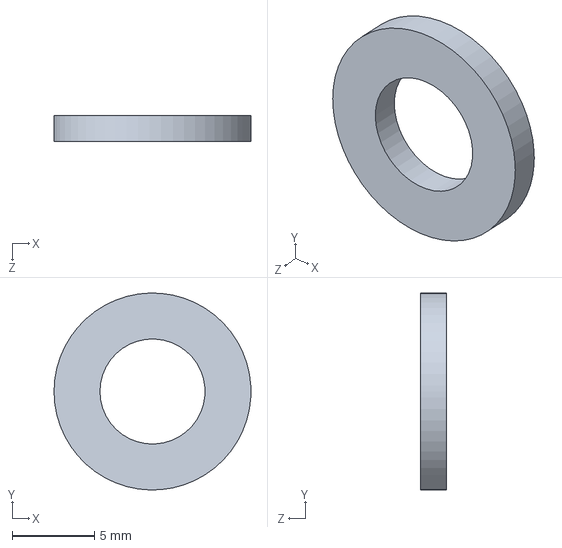
[picture p66: CAD file, 2026-11-08]
cad/original_solidworks/M6_DIN125 PUL.SLDPRT
12.0 x 12.0 x 1.60 mm
