mustafa11313/intelligent-cnc-vertical-drilling-machine/cad/step/limit_sensor_bracket_M12.step

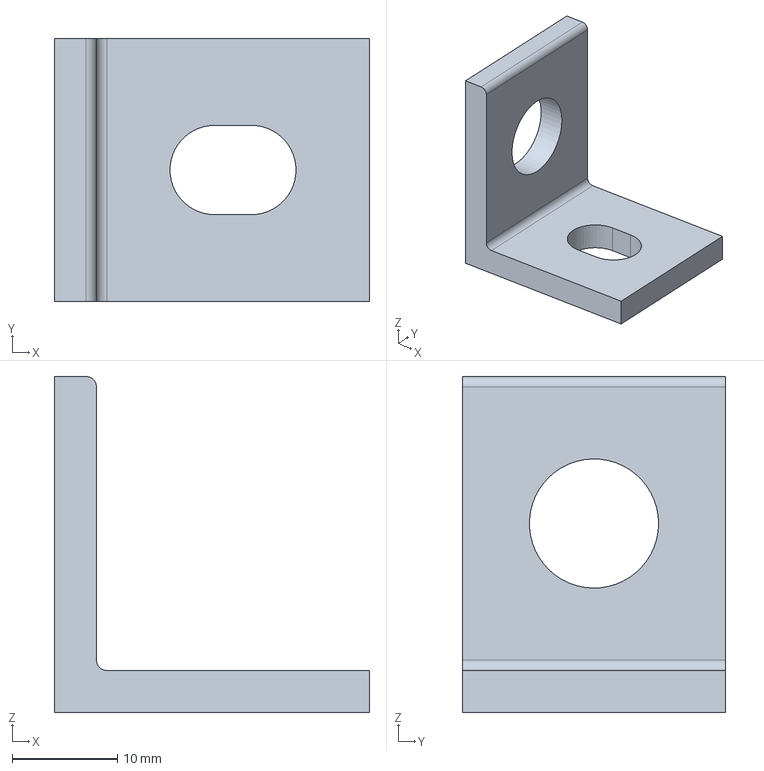
[picture p67: CAD file, 2026-11-08]
cad/step/limit_sensor_bracket_M12.step
30.0 x 25.0 x 32.0 mm
