mustafa11313/intelligent-cnc-vertical-drilling-machine/cad/step/pcb_riser_200x200x45.step

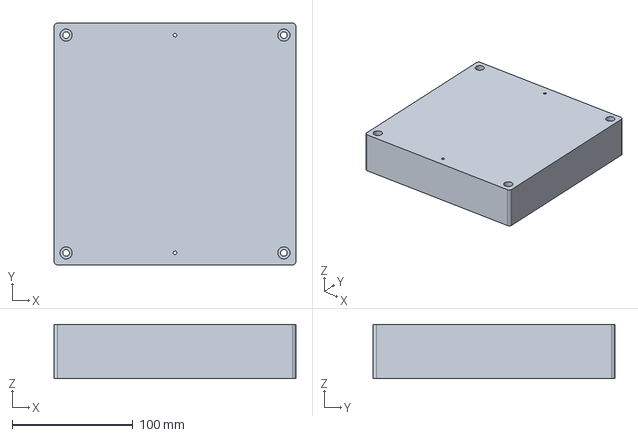
[picture p68: CAD file, 2026-11-08]
cad/step/pcb_riser_200x200x45.step
200.0 x 200.0 x 45.0 mm
