mustafa11313/intelligent-cnc-vertical-drilling-machine/cad/original_solidworks/X Eksen Somunu.SLDPRT

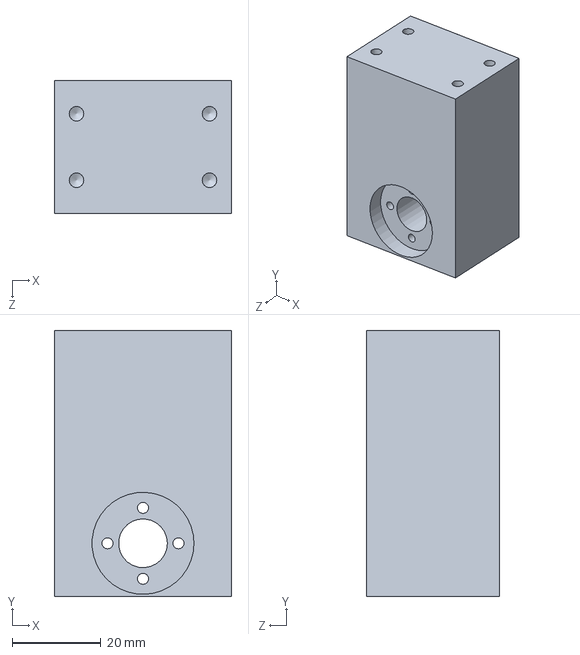
[picture p69: CAD file, 2026-11-08]
cad/original_solidworks/X Eksen Somunu.SLDPRT
40.0 x 60.0 x 30.0 mm
