mustafa11313/intelligent-cnc-vertical-drilling-machine/cad/original_solidworks/hgh15ca_01.SLDPRT

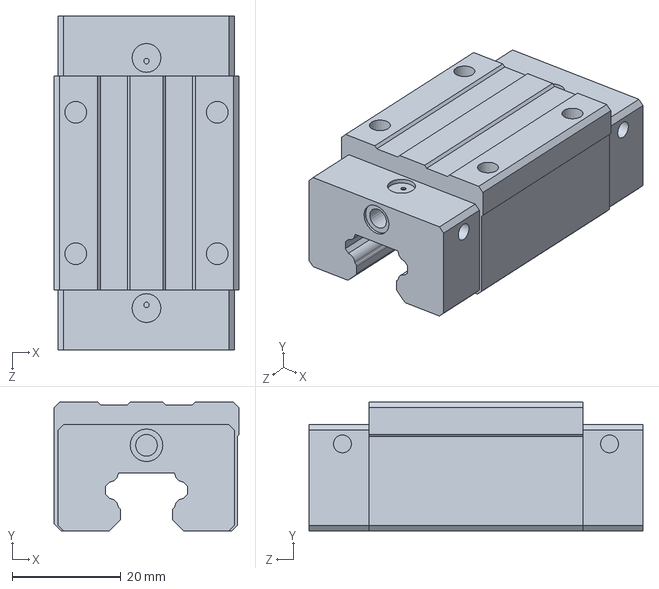
[picture p70: CAD file, 2026-11-08]
cad/original_solidworks/hgh15ca_01.SLDPRT
34.0 x 23.7 x 61.4 mm
