mustafa11313/intelligent-cnc-vertical-drilling-machine/cad/original_solidworks/45x90_light sigma profil_L=311.5.SLDPRT

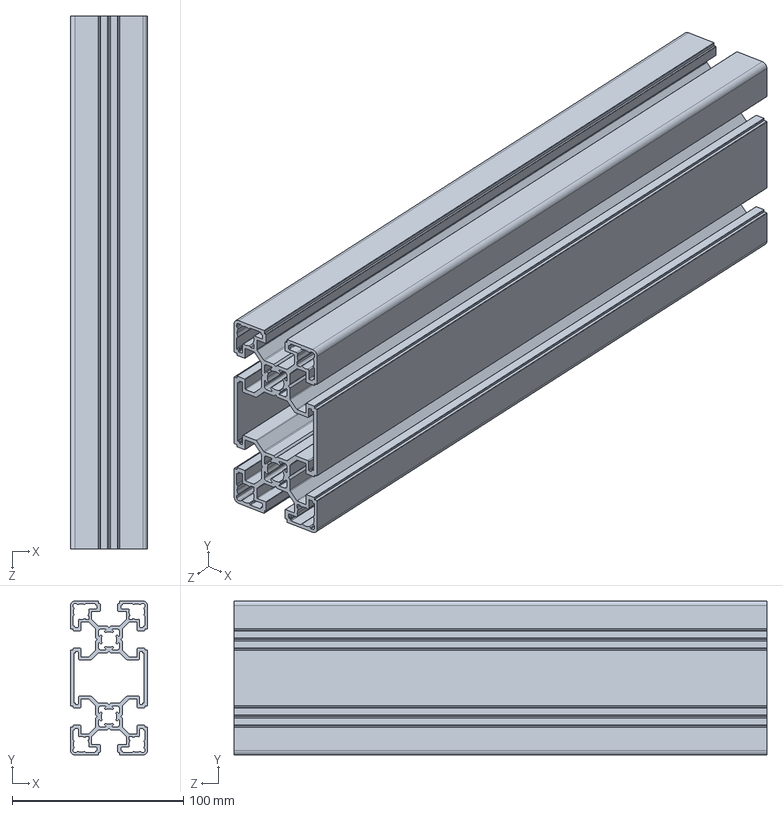
[picture p71: CAD file, 2026-11-08]
cad/original_solidworks/45x90_light sigma profil_L=311.5.SLDPRT
45.0 x 90.0 x 311.5 mm
