mustafa11313/intelligent-cnc-vertical-drilling-machine/cad/original_solidworks/HGR 15H RAY-1-Z EKSEN.SLDPRT

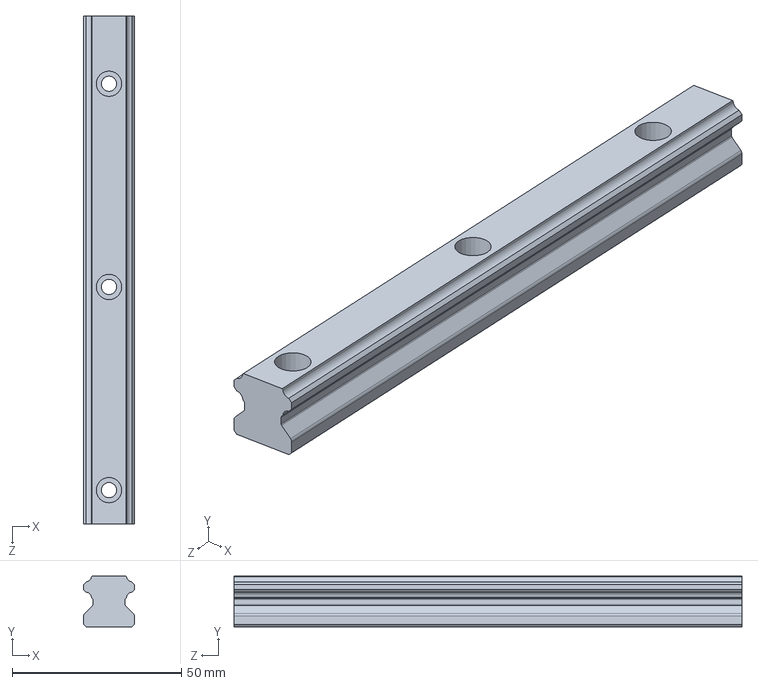
[picture p72: CAD file, 2026-11-08]
cad/original_solidworks/HGR 15H RAY-1-Z EKSEN.SLDPRT
15.0 x 15.0 x 150.0 mm
