mustafa11313/intelligent-cnc-vertical-drilling-machine/cad/original_solidworks/Spindle_Tutucu.SLDPRT

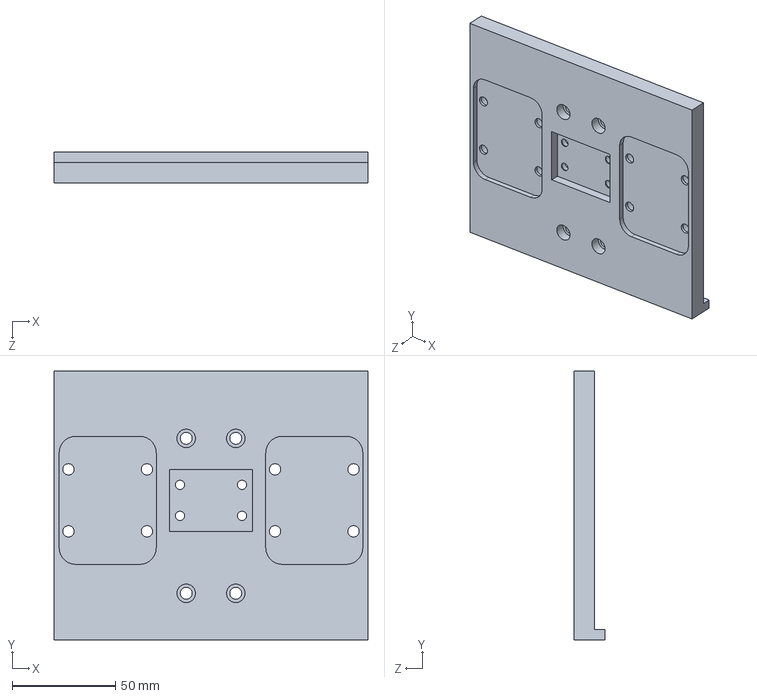
[picture p73: CAD file, 2026-11-08]
cad/original_solidworks/Spindle_Tutucu.SLDPRT
152.0 x 130.0 x 15.0 mm
