mustafa11313/intelligent-cnc-vertical-drilling-machine/cad/original_solidworks/Z Eksen Somunu.SLDPRT

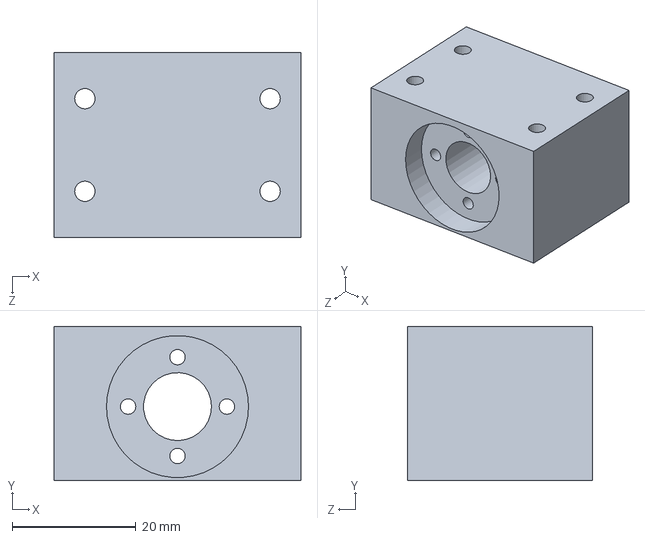
[picture p74: CAD file, 2026-11-08]
cad/original_solidworks/Z Eksen Somunu.SLDPRT
40.0 x 25.0 x 30.0 mm
