mustafa11313/intelligent-cnc-vertical-drilling-machine/cad/original_solidworks/ER 16 PENS1.SLDPRT

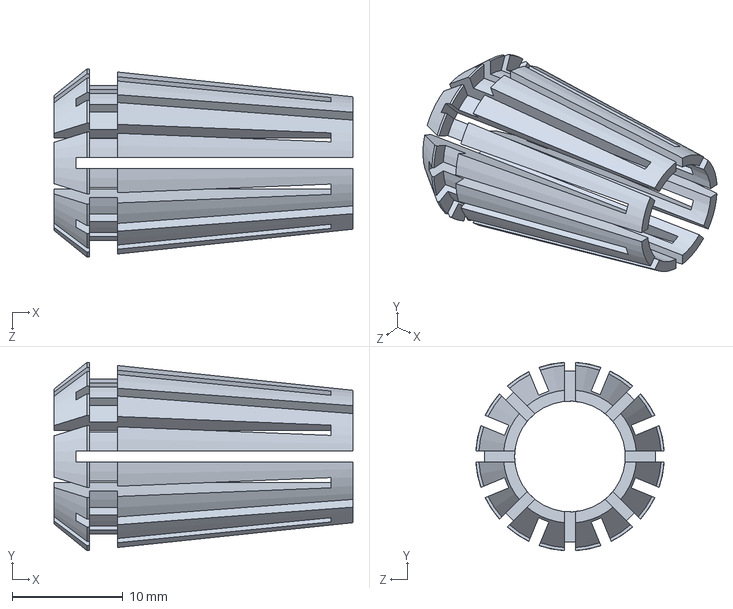
[picture p75: CAD file, 2026-11-08]
cad/original_solidworks/ER 16 PENS1.SLDPRT
27.0 x 17.0 x 17.0 mm
