mustafa11313/intelligent-cnc-vertical-drilling-machine/cad/original_solidworks/HGR 15H RAY-1.SLDPRT

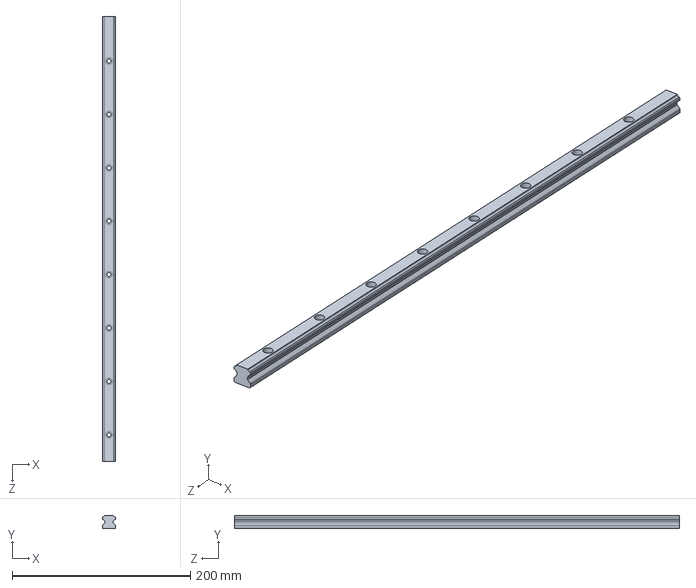
[picture p76: CAD file, 2026-11-08]
cad/original_solidworks/HGR 15H RAY-1.SLDPRT
15.0 x 15.0 x 500.0 mm
