mustafa11313/intelligent-cnc-vertical-drilling-machine/cad/original_solidworks/Y_Trapez_Kozmetik_Tr8x2.SLDPRT

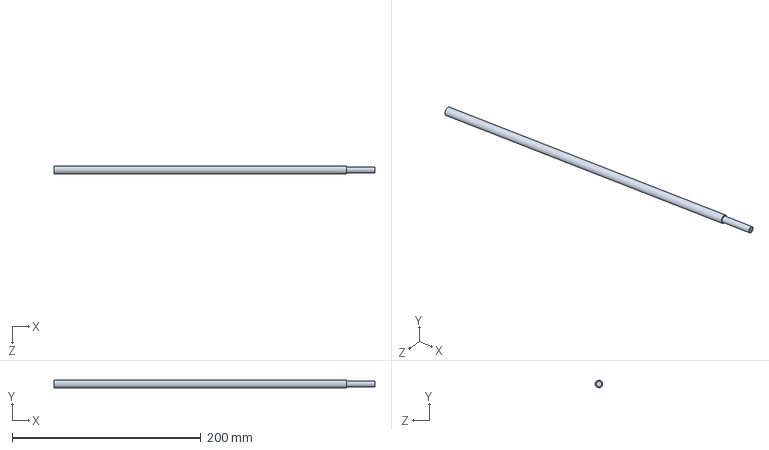
[picture p77: CAD file, 2026-11-08]
cad/original_solidworks/Y_Trapez_Kozmetik_Tr8x2.SLDPRT
340.0 x 7.98 x 7.97 mm
