mustafa11313/intelligent-cnc-vertical-drilling-machine/cad/original_solidworks/drill_bit_10d0.stp.SLDPRT

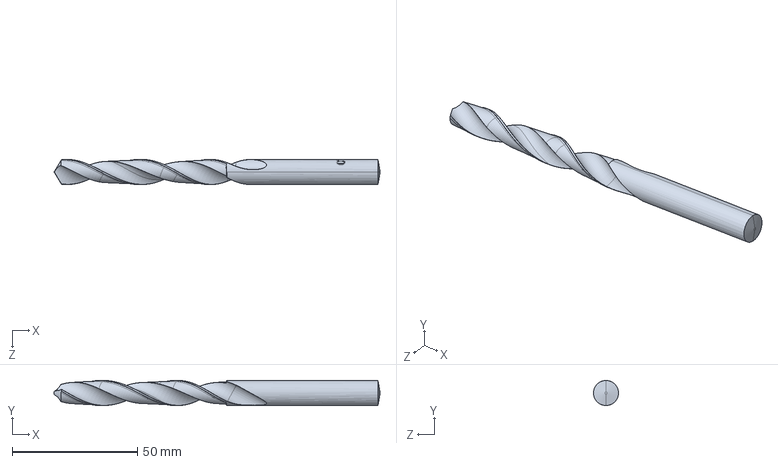
[picture p78: CAD file, 2026-11-08]
cad/original_solidworks/drill_bit_10d0.stp.SLDPRT
130.0 x 10.0 x 10.00 mm
