mustafa11313/intelligent-cnc-vertical-drilling-machine/cad/original_solidworks/Tabla2.SLDPRT

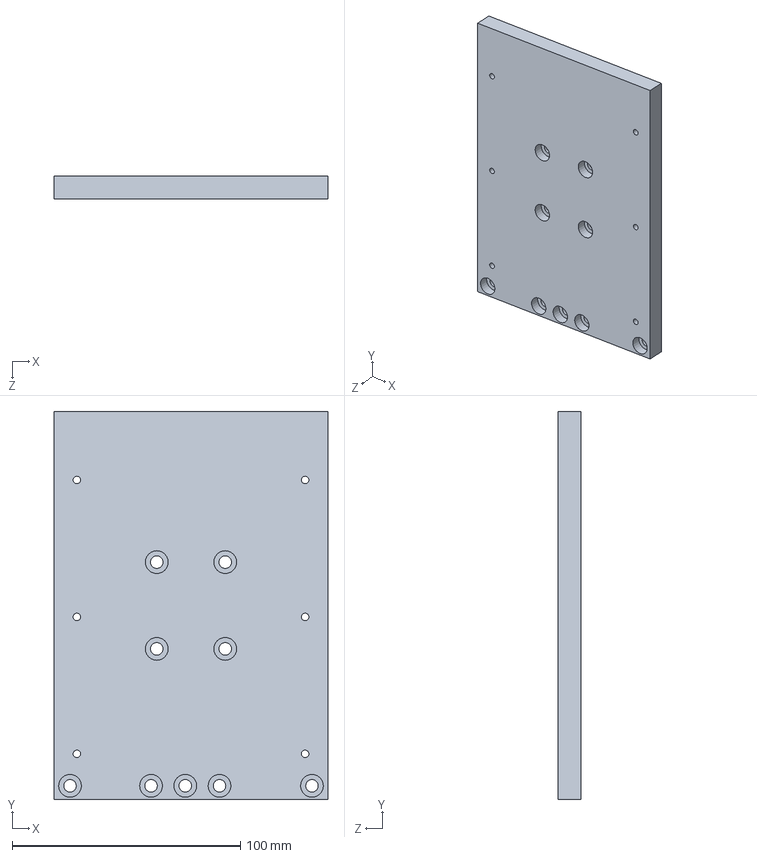
[picture p79: CAD file, 2026-11-08]
cad/original_solidworks/Tabla2.SLDPRT
120.0 x 170.0 x 10.0 mm
