mustafa11313/intelligent-cnc-vertical-drilling-machine/cad/original_solidworks/stepper_am17hd6426-06n_02.SLDPRT

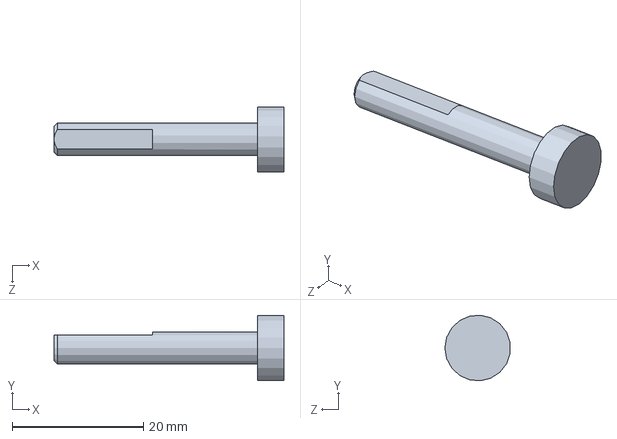
[picture p80: CAD file, 2026-11-08]
cad/original_solidworks/stepper_am17hd6426-06n_02.SLDPRT
35.0 x 9.97 x 9.93 mm
