mustafa11313/intelligent-cnc-vertical-drilling-machine/cad/original_solidworks/X_Trapez_Kozmetik_Tr8x2.SLDPRT

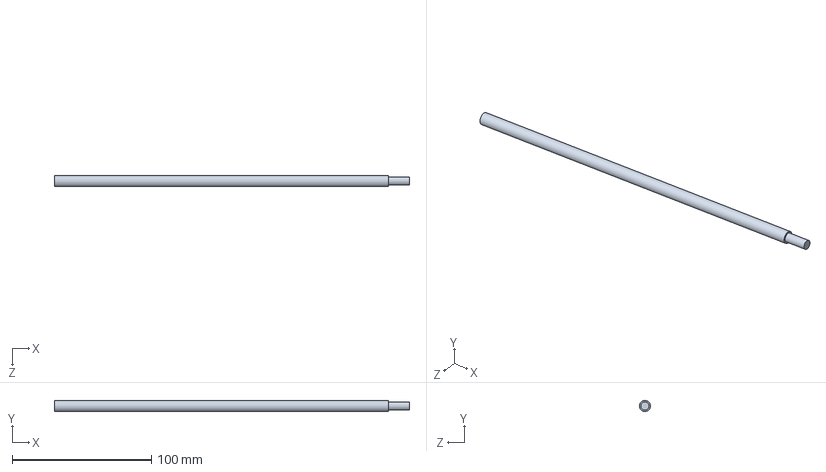
[picture p81: CAD file, 2026-11-08]
cad/original_solidworks/X_Trapez_Kozmetik_Tr8x2.SLDPRT
255.0 x 7.99 x 7.97 mm
