mustafa11313/intelligent-cnc-vertical-drilling-machine/cad/original_solidworks/45x90_light sigma profil_L=500.SLDPRT

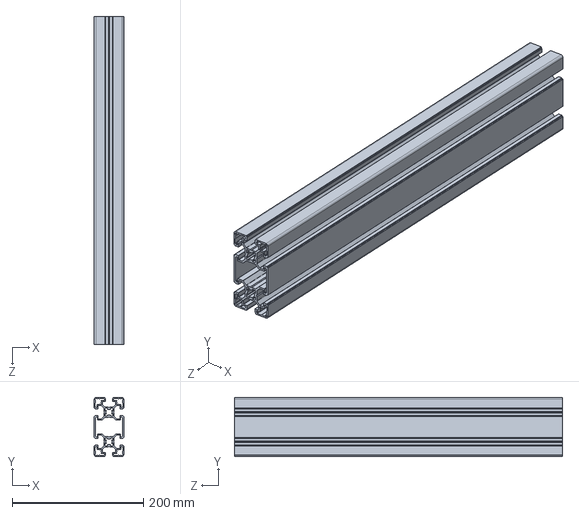
[picture p82: CAD file, 2026-11-08]
cad/original_solidworks/45x90_light sigma profil_L=500.SLDPRT
45.0 x 90.0 x 500.0 mm
