mustafa11313/intelligent-cnc-vertical-drilling-machine/cad/original_solidworks/Vidal#U0131 mil somunu.SLDPRT

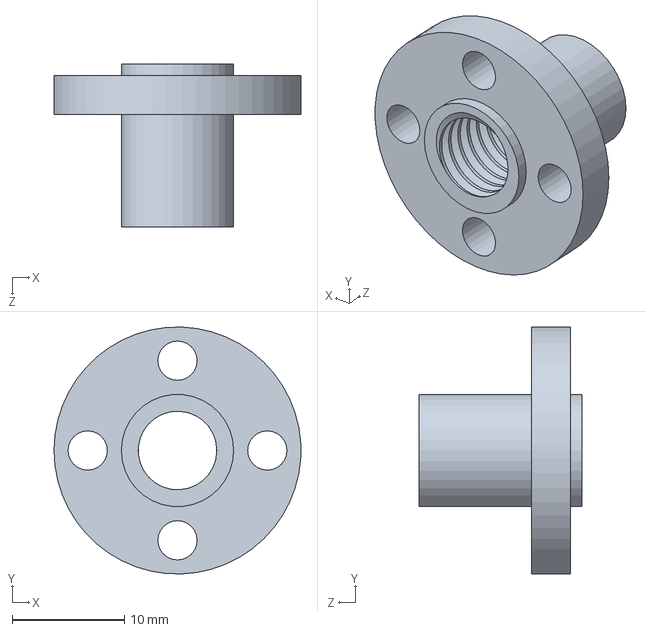
[picture p83: CAD file, 2026-11-08]
cad/original_solidworks/Vidal#U0131 mil somunu.SLDPRT
22.0 x 22.0 x 14.5 mm
