mustafa11313/intelligent-cnc-vertical-drilling-machine/cad/original_solidworks/NEMA17_Coupler.SLDPRT

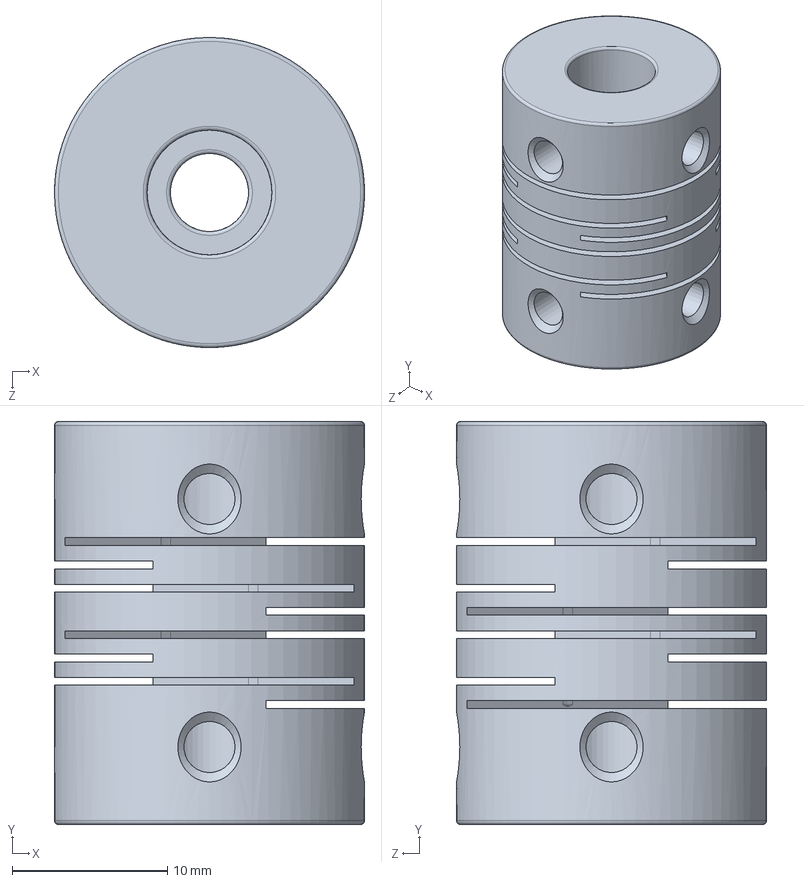
[picture p84: CAD file, 2026-11-08]
cad/original_solidworks/NEMA17_Coupler.SLDPRT
20.0 x 26.0 x 20.0 mm
