mustafa11313/intelligent-cnc-vertical-drilling-machine/cad/original_solidworks/Z_Trapez_Kozmetik_Tr8x2x129.SLDPRT

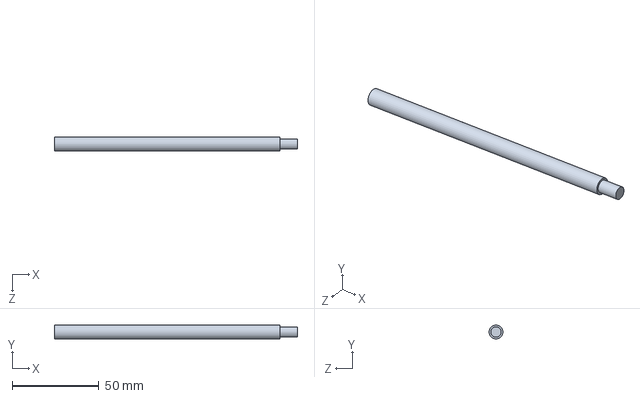
[picture p85: CAD file, 2026-11-08]
cad/original_solidworks/Z_Trapez_Kozmetik_Tr8x2x129.SLDPRT
140.0 x 7.96 x 8.00 mm
