mustafa11313/intelligent-cnc-vertical-drilling-machine/cad/original_solidworks/stepper_am17hd6426-06n_01.SLDPRT

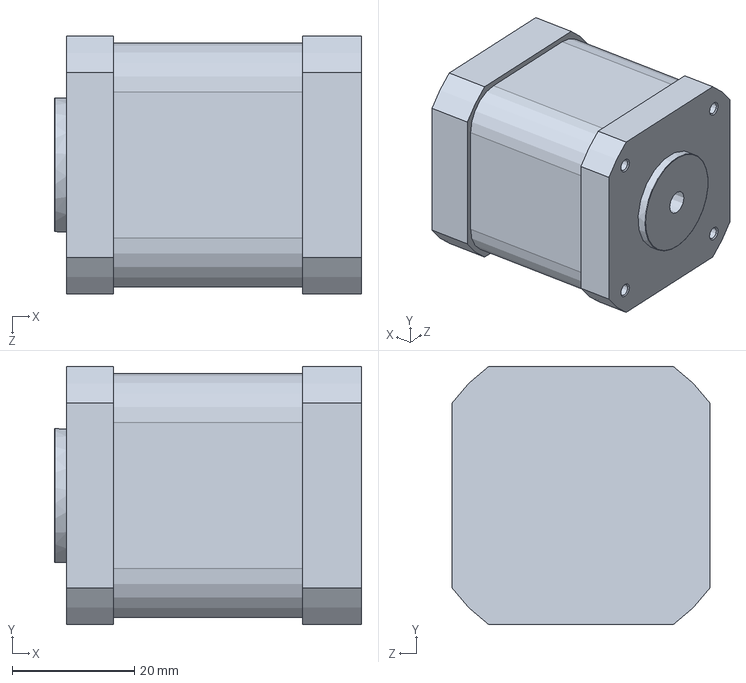
[picture p86: CAD file, 2026-11-08]
cad/original_solidworks/stepper_am17hd6426-06n_01.SLDPRT
50.3 x 42.3 x 42.3 mm
