mustafa11313/intelligent-cnc-vertical-drilling-machine/cad/original_solidworks/HGW 15CC-1.SLDPRT

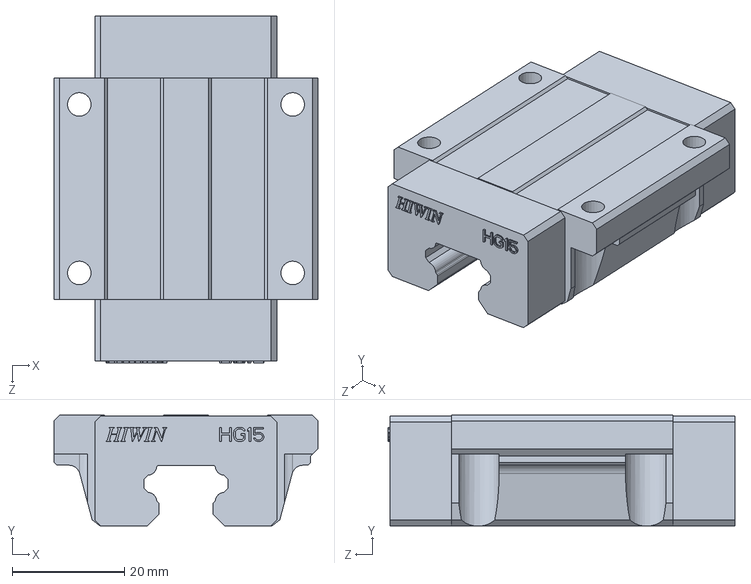
[picture p87: CAD file, 2026-11-08]
cad/original_solidworks/HGW 15CC-1.SLDPRT
47.0 x 19.7 x 61.7 mm
