mustafa11313/intelligent-cnc-vertical-drilling-machine/cad/original_solidworks/Y eksen Ray.SLDPRT

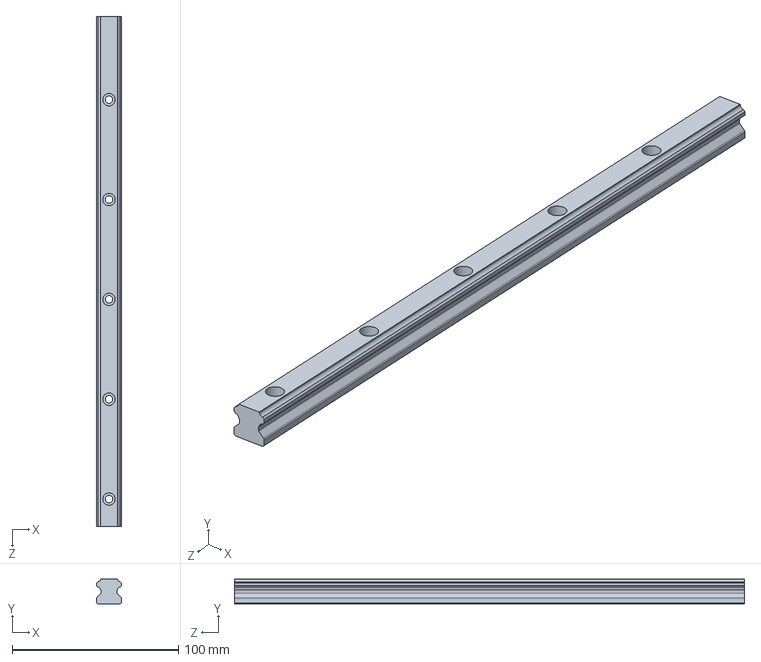
[picture p88: CAD file, 2026-11-08]
cad/original_solidworks/Y eksen Ray.SLDPRT
15.0 x 15.0 x 306.5 mm
