mustafa11313/intelligent-cnc-vertical-drilling-machine/cad/original_solidworks/Arka_Kapak-Son.SLDPRT

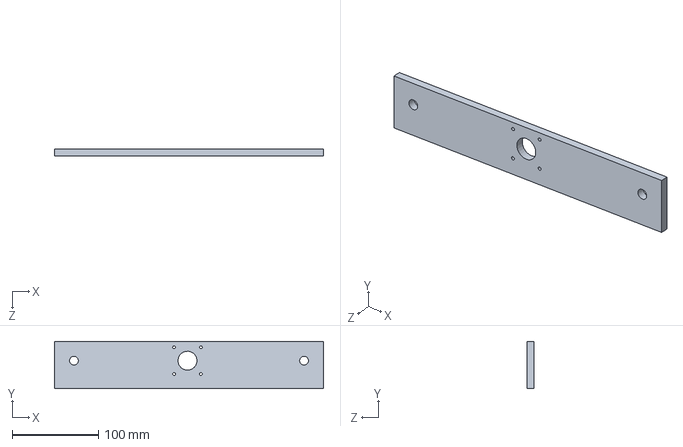
[picture p89: CAD file, 2026-11-08]
cad/original_solidworks/Arka_Kapak-Son.SLDPRT
311.5 x 55.0 x 8.00 mm
