mustafa11313/intelligent-cnc-vertical-drilling-machine/cad/original_solidworks/Ana_Montaj_1_6_25.SLDASM

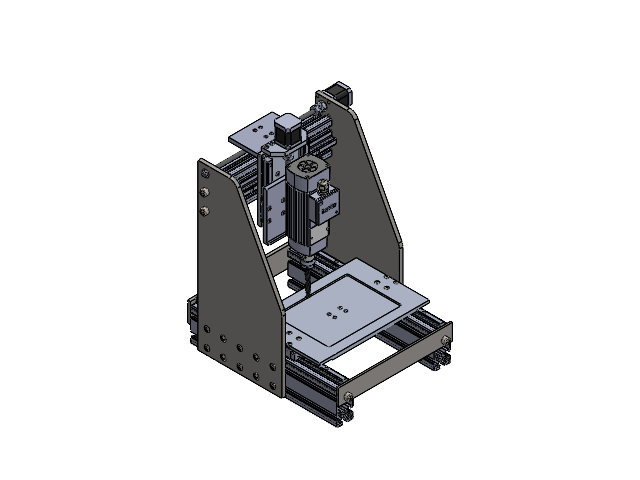
[picture p90: CAD file, 2026-11-08]
cad/original_solidworks/Ana_Montaj_1_6_25.SLDASM
45x90_light sigma profil_L=500 x 2
HGR 15H RAY-1 x 2
Yan_Plaka_1
2.1.001.10.08.step x 5
Arka_Kapak-Son
stepper_am17hd6426-06n_01 x 3
stepper_am17hd6426-06n_02 x 3
NEMA17_Coupler x 3
Yan_Plaka_2
45x90_light sigma profil_L=311.5
Y eksen Ray
Y eksen takozu
HMA85_ER16S-AK-1R(2)^Spindle_Yarıkomple
drill_bit_10d0.stp
ER 16 PENS1
ER 161
Spindle_Tutucu
HGW 15CC-1 x 3
M5x12 x 33
Z Eksen Somunu
Vidalı mil somunu x 3
HGR 15H RAY-1-Z EKSEN x 2
Z_Trapez_Kozmetik_Tr8x2x129
Tabla2
nut_din934_m6-6 x 3
M6_DIN125 PUL x 3
Arka Kapak
M3 x12 x 8
Y_Trapez_Kozmetik_Tr8x2
Y Eksen Somunu_son
M4x12 x 8
ISO 4762 M10 x 20 - 20N x 8
ISO 4762 M8 x 16 - 16N x 20
hgh15ca_01 x 2
X_Trapez_Kozmetik_Tr8x2
300x250 Is Tablasi
X Eksen Somunu
On_Kapak-Son
