mustafa11313/intelligent-cnc-vertical-drilling-machine/cad/original_solidworks/Spindle_Yar#U0131komple.SLDASM

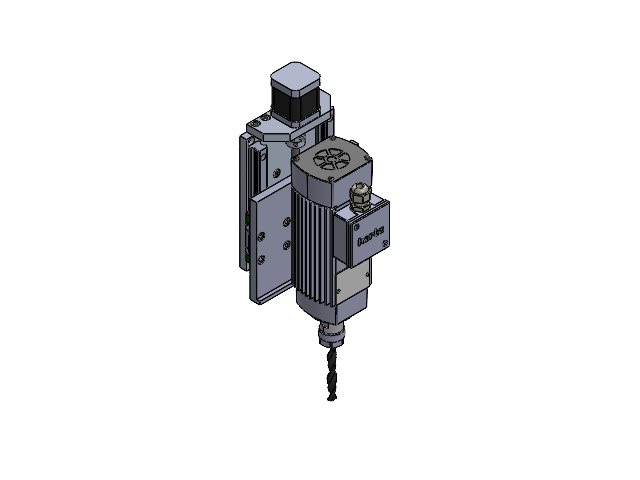
[picture p91: CAD file, 2026-11-08]
cad/original_solidworks/Spindle_Yar#U0131komple.SLDASM
HMA85_ER16S-AK-1R(2)^Spindle_Yarıkomple
drill_bit_10d0.stp
ER 16 PENS1
ER 161
Spindle_Tutucu
HGW 15CC-1 x 3
M5x12 x 20
Z Eksen Somunu
Vidalı mil somunu
HGR 15H RAY-1-Z EKSEN x 2
Z_Trapez_Kozmetik_Tr8x2x129
Tabla2
nut_din934_m6-6
M6_DIN125 PUL
NEMA17_Coupler
Arka Kapak
stepper_am17hd6426-06n_01
stepper_am17hd6426-06n_02
M3 x12 x 4
