mustafa11313/intelligent-cnc-vertical-drilling-machine/(list of files, cad)

Other CAD files:
cad/step/full_machine_enclosed.step
cad/step/full_machine_upgraded.step
tests/data/SINGLEPOINTtest.DXF
cad/original_solidworks/Yan_Plaka_1.SLDPRT
cad/original_solidworks/Y Eksen Somunu_son.SLDPRT
cad/original_solidworks/300x250 Is Tablasi.SLDPRT
cad/original_solidworks/On_Kapak-Son.SLDPRT
cad/original_solidworks/ISO 4762 M10 x 20 - 20N.SLDPRT
cad/original_solidworks/ISO 4762 M8 x 16 - 16N.SLDPRT
cad/original_solidworks/M4x12.SLDPRT
cad/original_solidworks/M5x12.SLDPRT
cad/original_solidworks/Parasolid/Ana_Montaj_1_6_25.x_t
cad/original_solidworks/Step/Ana_Montaj_1_6_25.SLDASM
cad/original_solidworks/nut_din934_m6-6.SLDPRT
cad/step/nut_block_antibacklash_Tr8.step
