mustafa11313/intelligent-cnc-vertical-drilling-machine/cad/assembly_views.png

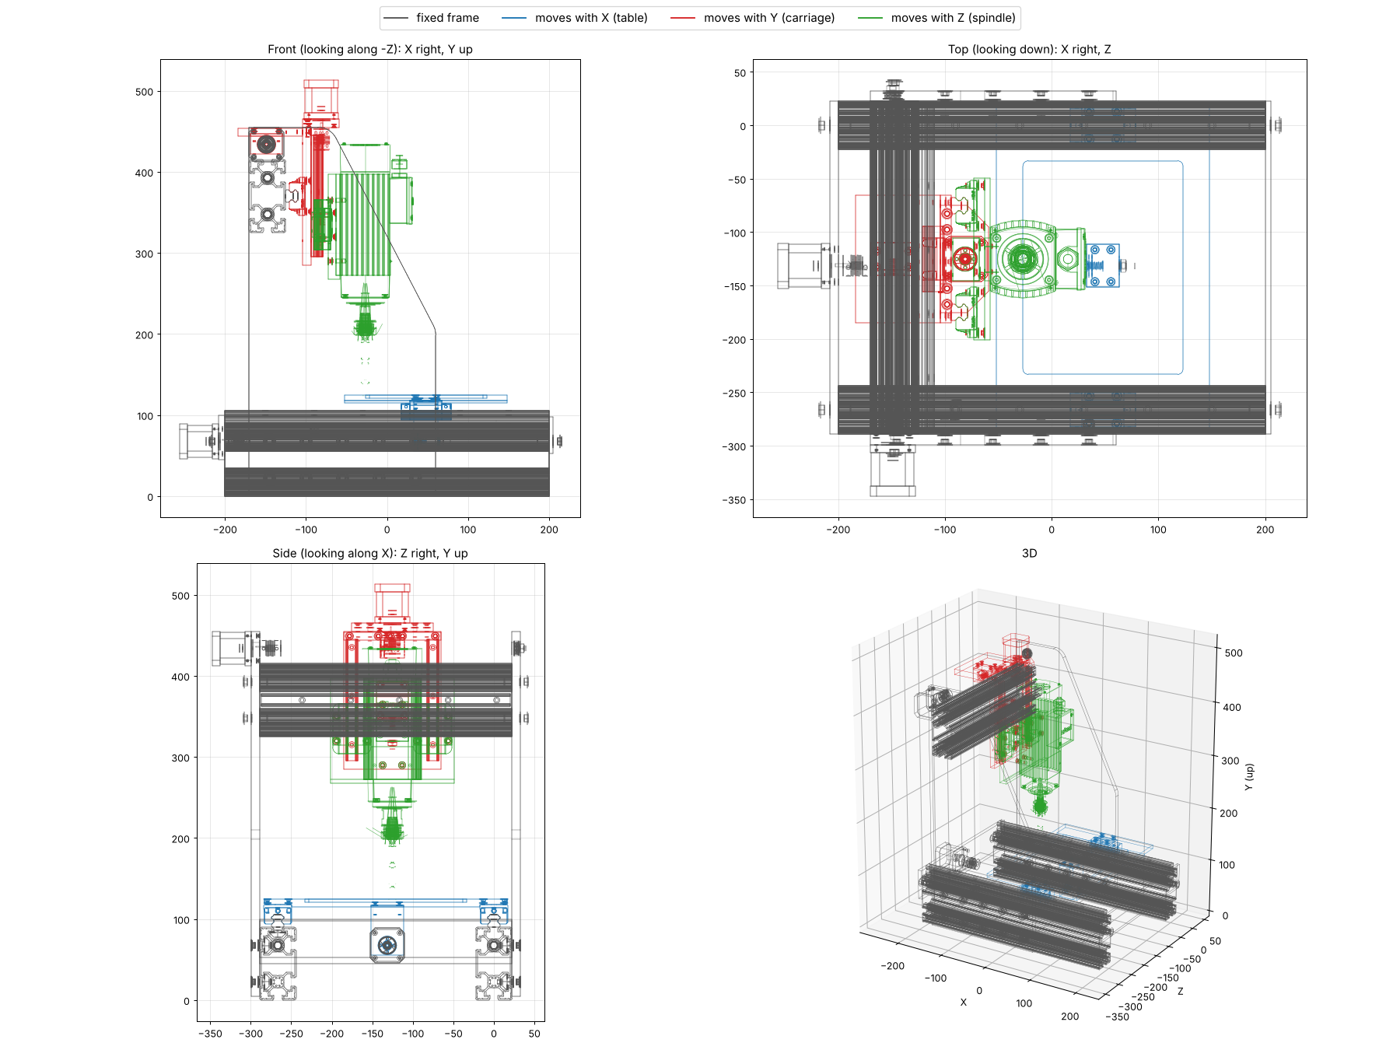
cad/assembly_views.png
