mustafa11313/intelligent-cnc-vertical-drilling-machine/(commit log)

2026-11-08 Intelligent CNC vertical drilling machine v2 and new CNC router design
    Control software reworked for Ubuntu 22.04 with a simulator and tests,
    DAQ firmware, electronics review, CAD review and upgrade of the drilling
    machine, and the CAD of a new CNC router (in design).
    [SINGLEPOINTtest.DXF, Spicemen.DXF, Spicemen2.DXF, Spicemen3.DXF, assembly_parts.csv, head_yoke_camera.step, limit_sensor_bracket_M12.step, nut_block_antibacklash_Tr8.step]
2026-11-08 Machine upgrade: full CAD, electrical box, cover, sensors, head camera quality check
    - Full machine as STEP (original, upgraded, in its cover), Z up, with renders
    - Electrical enclosure modelled with real components and wiring
    - Machine cover: 20x20 profile cage, polycarbonate panels, door interlock, cut and buy lists
    - All sensors placed in the CAD: home switches, DS18B20 probes, ADXL345, SCT-013, head camera
    - Home switches and homing in the app, GRBL safety door handling
    - Head camera quality check against the drawing, hole by hole
    - E-stop and door interlock wiring, updated diagrams, stiffness check, calibration steps
    - Original SolidWorks design and Parasolid export
    [2.1.001.10.08.step.SLDPRT, 300x250 Is Tablasi.SLDPRT, 45x90_light sigma profil_L=311.5.SLDPRT, 45x90_light sigma profil_L=500.SLDPRT, 626.SLDPRT, Ana_Montaj_1_6_25.SLDASM, Ana_Montaj_1_6_25.x_t, Arka Kapak.SLDPRT]
